sinara-hw/Pounder/README.md

# Pounder
PDH/phase lock signal generator for Stabilizer

## Design Files

Design files (schematics, PCB layouts, BOMs) can be found at [Pounder/Releases](https://github.com/sinara-hw/Pounder/releases).

## Wiki

More information can be found on the [wiki](https://github.com/sinara-hw/Pounder/wiki).
