sinara-hw/Pounder/(threads)

Thread 1 (2018-11-12):

[RFC] New EEM: Pounder (PDH lock signal generator)

dtcallcock, 2018-11-12:
[Pound Drever Hall](https://en.wikipedia.org/wiki/Pound–Drever–Hall_technique) locks are pretty ubiquitous in laser labs.  It would be nice to have a Sinara board that does all the necessary modulation and demodulation.

It would sit alongside one of the proposed servo cards such as [Stabilizer (Microcontroller Servo)](https://github.com/sinara-hw/meta/issues/27) or [Fast Kasli Lock](
https://github.com/sinara-hw/meta/issues/26).

There are commercial models available from [Toptica](https://www.toptica.com/products/tunable-diode-lasers/laser-locking-electronics/pdd-110f-pound-drever-hall/), [Also Toptica](https://www.toptica.com/products/tunable-diode-lasers/laser-locking-electronics/pdhdlc-pro-pound-drever-hall/), [Sacher](https://www.sacher-laser.com/home/lab-equipment/locking_equipment/servo_controller/top_of_line_modulator_demodulator-lb20.html), [Qubig](http://www.qubig.com/rf-drivers.htm), and [Stable Laser Systems](http://stablelasers.com/products/pound-drever-hall-signal-unit/).  I haven't used most of them but none look like they quite do what we want.  At NIST we usually just roll our own from a two-channel standalone DDS, a pile of Minicircuits bits and some custom passive rf filters and a custom active LPF on the output.

Interface could be EEM and/or Ethernet.  Having no Ethernet will be obnoxious if we don't want to put an EEM master on Stabilizer.  Having ethernet could also make the board on option for people who aren't otherwise using Sinara - the fact there are quite a few commercial products out there demonstrates there is at least some market.

dtcallcock, 2019-06-02:
Just to finish answering @gkasprow questions:

> Low pass filter series: LFCN-3000+

Yes, the Minicircuits FV1206 package used in this part should be fine for DDS band defining filters.  How about [LFCN-160+](https://www.minicircuits.com/pdfs/LFCN-160+.pdf) (-1.5dB @205MHz, -19dB@300MHz) as the default population?

> Fixed attenuators: YAT-12+

MCL YAT series sounds fine.

> modulators: ADL5375-05ACPZ-R7, ADL5380ACPZ-R7

I think we just want a double-balanced mixer rather that an AD part. Will open another thread on this.

> Low noise generators: CCHD-950-25-100.000, Si570, Si549

See thread on DDS clocking.

dtcallcock, 2019-06-02:
> what are the second two dds channels for?

For the other PDH channel that's a copy of the first.  Reasoning from above:

- It isn't much extra work (just copy and paste the analog section) and will probably add <100 of $ to the board cost.
- Stabilizer is 2-channel
- A lot of atomic references also have an AOM in the pump beam to offset it. You could use one of the two LO outputs for this instead of a second PDH lock. My guess it that this is why Qubig's box has an 'aux LO' output.

gkasprow, 2019-09-21:
Here are more-or-less finished schematics. CPU IO assignment is missing.
[Pounder.PDF](https://github.com/sinara-hw/Pounder/files/3639019/Pounder.PDF)

Closed 2019-11-30.

Thread 2 (2019-06-02):

DDS Clocking

dtcallcock, 2019-06-02:
How about using the same 100MHz oscillator ([CCHD-950-25-100.00](http://www.crystek.com/crystal/spec-sheets/clock/CCHD-950.pdf)) and MUX ([Si53340-B](https://www.silabs.com/documents/public/data-sheets/si5334x-datasheet.pdf)) as Urukul to allow selection between XTAL and ext ref?

Only issue is that Si53340-B has LVDS outputs and AD9959 datasheet only talks about connecting LVPECL and PECL clocks.

Ext ref could be a front panel SMA or internal MMCX depending on front panel space and perceived likelihood people will use it.

To answer @hartytp questions:

> what’s the use-case for the ext ref? Synchronised locks?

Yes.  But also:
- In some kinds of modulation schemes (like ones with an offset AO) the DDS output gets added to the laser frequency and so you might want that frequency locked to a reference.
- The phase noise of the DDS is improved by bypassing the internal multiplier.  An ext ref would allow people to provide their own low phase noise 500MHz reference.

> If so is it worth having a ref out port?

Sure.  One of the other outputs of the MUX could be taken to an MMCX.

gkasprow, 2019-06-02:
The AD9959 clock input requires min 400mVpp input clock.
The Si53340-B specification says that it delivers 200mV..490mV single ended swing which means min 400mV pp. So that should work. If we route 120Ohm tracks and place 120Ohm load than we would get sth like additional 20% margin. But IMHO we already are well within spec.

dnadlinger, 2019-07-17:
> what’s the use-case for the ext ref? Synchronised locks?

For fibre noise cancellation (#7), one would definitely want to use a good external reference as well.

gkasprow, 2019-09-21:
copied directly from Urukul, added SMA input isolation
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

dtcallcock, 2019-09-21:
Can Q1 go to an MMCX so that the 100MHz internal oscillator is available if needed?

> added SMA input isolation

So EXT_CLK IN is a front panel SMA?  if so, what are the CK MMCX annotations next to CLK1 input on IC24?

gkasprow, 2019-09-21:
It is reminiscent from Urukul. Yes, it is SMA. OK for internal MMCX

dtcallcock, 2019-10-08:
Closing as new issues opened for remaining issues.

Closed 2019-10-08.

Thread 3 (2019-06-02):

Power Amp

dtcallcock, 2019-06-02:
An output amp that can do more that +10dBm would be useful as often with a PDH you are often driving a modulator like an EO.  I see three options:

- Add [TSS-13HLN+](https://www.minicircuits.com/pdfs/TSS-13HLN+.pdf) that can be switched in and out of output as described in [main thread](https://github.com/sinara-hw/Pounder/issues/1).  The [HMC1118](https://www.analog.com/media/en/technical-documentation/data-sheets/HMC1118.pdf) switch looks like it will be able to handle the power.  Power dissipation is 2W/channel and it might add ~$50 to the BoM.

- Leave room for power amps but make them DNP by default.  In that case I'd probably use the [PHA-13LN+](https://www.minicircuits.com/pdfs/PHA-13LN+.pdf).  It's a little less power (+23dBm) but it's an easily hand-solderable package and runs off 5V so wouldn't need dedicated rails populating (current draw is 160mA max per amp so presumably not that bad to build that margin in the existing 5V rail).  Lack of enable line also not an issue here.

- We could make a separate medium power RF amplifier board in Eurocard form factor (prob 2 ch).  Such a thing would be useful for other boards like Urukul/Mirny too - right now there is a bit of a gap in Sinara if you need RF power in the +10 to +25dBm range where Booster would be total overkill.

hartytp, 2019-06-02:
For AOs you’d usually need a bit more power than those wouldn’t you? The nice qubig EOs only need something like 13dBm. So is there enough of a use case for >16dBm <28dBm (which is prob more than you’d get after the switch) to be worth the hassle?

Personally I’d go for the biggest MMIC amp we’d be happy with (16dBm ish ideally) and let users stick an appropriate pre-packaged mcl amp on outside stabiliser if they need it (can always provide a header).

dtcallcock, 2019-06-04:
> For AOs you’d usually need a bit more power than those wouldn’t you?

Yes, but then using Booster would be reasonable.

> The nice qubig EOs only need something like 13dBm.

It's true that for some cavity locks powers can be really low.  For atomic locks though we run them with as much as 23dBm.

> stick an appropriate pre-packaged mcl amp on outside stabiliser if they need it (can always provide a header).

Isn't this the kind of thing we are trying to move away from with Sinara?  Is option 2 above much harder than this - it's just a MMIC so only needs a handful of external passives around it.

hartytp, 2019-06-04:
>  Is option 2 above much harder than this - it's just a MMIC so only needs a handful of external passives around it.

It's not so hard. The chip eats 140mA at 5V (700mW) so you'll have to make sure you spec the circuit out for this. Will prob require a 5V5 SMPS on the AFE mezzanine to generate the supply for that from the main 12V rail. That may be necessary anyway, depending on how much current the other components draw from that rail.

If it's a bit of a niche use-case then solder jumpers sound like a good idea (maybe populate the amp by default but use a 0R resistor to cut off its supply to make life easier?). If it's going to be common then worth thinking about the switches more seriously

dtcallcock, 2019-06-04:
> If it's a bit of a niche use-case then solder jumpers sound like a good idea. If it's going to be common then worth thinking about the switches more seriously

Yeah, I think that given the switch has to be a bit extra-special then solder jumpers are the way forward.

> maybe populate the amp by default but use a 0R resistor to cut off its supply to make life easier?

That would be my preference.  Adds $20 to the BoM is all.

hartytp, 2019-06-04:
Sounds good. If we find people aren't using it, we can always DNP it later on.

FWIW, I'd also be fine with connecting it to the output by default (I'm not so concerned with an extra 0.7W of power dissipation for this design as we won't have many channels of it).

gkasprow, 2019-09-21:
Attenuator schematic
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
power stage and switches
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

gkasprow, 2019-09-21:
What about using HC164 to drive the VGA?

gkasprow, 2019-09-21:
Or, I2C extenders would be simpler...

gkasprow, 2019-09-21:
Would it be OK from SW perspective to chain both attenuators serial interfaces and drive them from the same SPI?

dtcallcock, 2019-09-22:
If we go for the PHA-13LN+ amp (P1dB=+24dBm), which I think is probably the right choice, then we don't need those fancy HMC1118 switches (~$7 ea).  We can just re-use the [HMC349ALP4CE](https://www.analog.com/media/en/technical-documentation/data-sheets/HMC349ALP4CE.pdf) from Urukul. That switch is half the price and known-good.  The 0.1dB compression point is +31dBm and power handling is +33.5(+26.5) dBm on thru(terminated) path so it can handle the power.

The way the switches are connected right now, there isn't a way of switching off the output.  Obviously you could switch to the power amp route but leave the power amp powered down.  I don't know if that's safe or how much isolation it would give though.  On the other hand, the DDS has amplitude control so one can just set that to zero if desired.

dtcallcock, 2019-09-22:
The passives around the [PHA-13LN+](https://www.minicircuits.com/pdfs/PHA-13LN+.pdf) don't match the suggested datasheet values.  Also there is capacitor missing (C1 on datasheet) and the input capacitor and inductor (C2 and L2 on datasheet are switched).  Is there a reason for this?

dtcallcock, 2019-10-08:
> We could make a separate medium power RF amplifier board in Eurocard form factor (prob 2 ch). Such a thing would be useful for other boards like Urukul/Mirny too - right now there is a bit of a gap in Sinara if you need RF power in the +10 to +25dBm range where Booster would be total overkill.

It sounds like this might be worth revisiting if there isn't a suitable MCL amp.

Otherwise closing.

Closed 2019-10-08.

Thread 4 (2019-06-02):

Mixer

dtcallcock, 2019-06-02:
>>>> We use Minicircuits [SYPD-1+](https://www.minicircuits.com/pdfs/SYPD-1+.pdf) phase detectors btw. Does anyone have experience with something else?

>>> IIRC, there is nothing special about those phase detectors, they're just mixers. Any decent (good isolation/LO leakage) will do just fine.

>> Yep. The main reason we use them is that they are specified for phase detection so you know what performance you will get rather than having to infer or test - for example with a random mixer you may end up with some annoying drifty dc offset. Minicircuits have a nice application note on the subject.

> IIRC, the phase detectors are mainly specified with the RF input saturated, which is not what one generally wants for an atomic lock. With the RF input unsaturated there is less difference between a phase detector and a decent DBM. There is a good Marki app note on mixers as well. IIRC their conclusion is that isolation is a very good proxy for general mixer performance and, having done some really careful tests that use mixers as phase detectors, I've never had an issue with large offsets in mixers that have decent isolation/LO leakage etc.

> Anyway, if there is a phase detector mixer that covers the frequency band, power range etc that we need then sure, let's go for it. If not, then let's just use a decent mixer. I'm equally happy either way.

@hartytp Do you want to suggest a part number you have had good experience with or shall we go with the SYPD-1+?

hartytp, 2019-06-02:
I’ve done quite a lot of microwave interferometry recently and have generally found that any MCL DBM will be fine. The Marki app note is prob right that isolation is a good thing but usually the mcl/marki/etc mixers all have about the same specs. I can dig out the pn of the mixer we used in our home brew pdh box if you want, but personally I’d just go for anything with the right frequency range

dtcallcock, 2019-06-03:
> I can dig out the pn of the mixer we used in our home brew pdh box if you want, but personally I’d just go for anything with the right frequency range

You used an MCL [ADE-1L](https://www.minicircuits.com/pdfs/ADE-1L.pdf) but it doesn't quite go low enough in frequency.  It looks like the MCL [ADE-1+](https://www.minicircuits.com/pdfs/ADE-1+.pdf) will do the job though.

Btw, here is another nice article on mixer selection: http://www.rfcafe.com/references/articles/wj-tech-notes/Mixers_phase_detectors.pdf

dnadlinger, 2019-07-17:
Measurements of DBM residual phase noise are hard to come by. There is a NIST paper with some results: Barnes et al., Residual PM Noise Evaluation of Radio Frequency Mixers (2011), [doi:10.1109/FCS.2011.5977868](https://ieeexplore.ieee.org/document/5977868). As Tom mentioned, most should work for our use case.

dnadlinger, 2019-07-18:
> the phase detectors are mainly specified with the RF input saturated

Just for the sake of completeness, for fibre nosie cancellation (#7), we'd want to use the mixer as a pure phase detector, i.e. well saturated.

gkasprow, 2019-09-20:
What's the conclusion then?
 Is MCL ADE-1+ fine?

dnadlinger, 2019-09-20:
The ADE-1+ looks like it should work. Let's just make sure that we have enough LO power available to saturate it (probably around 10 or 11 dBm), and to terminate the IF output into 50Ω at high frequencies (series RC to ground plus LRC for the DC path).

gkasprow, 2019-09-20:
OK, what about the LO amplifier? Would [ERA-2SM+](https://ww2.minicircuits.com/pdfs/ERA-2SM+.pdf) work here?
We also need VGA. What gain and frequency range do you need? Do you have some candidate?
Digitally controlled would be fine, but we have also two free DAC outputs from CPU.

gkasprow, 2019-09-20:
What about the coupler? Would [TCD-9-1WX+](https://ww2.minicircuits.com/pdfs/TCD-9-1WX+.pdf) already used in the Booster work for you?

dtcallcock, 2019-09-20:
> OK, what about the LO amplifier? Would ERA-2SM+ work here?

Looks good.

> What about the coupler? Would TCD-9-1WX+ already used in the Booster work for you?

No, that part is 5-2000 MHz.  I want to run the LO as low at 1MHz.

> We also need VGA. What gain and frequency range do you need? Do you have some candidate?
Digitally controlled would be fine, but we have also two free DAC outputs from CPU.

Where on the [block diagram](https://github.com/sinara-hw/Pounder/issues/1#issuecomment-497855600) would this VGA be?

dnadlinger, 2019-09-20:
> What about the coupler? Would TCD-9-1WX+ already used in the Booster work for you?

Not for the low-frequency locks @dtcallcock is targeting. The frequency range (1 MHz to 160 MHz) is a bit awkward in terms of directional couplers, though. Perhaps we can just use a tap as we don't need directionality? [ADCB-20-82+](https://ww2.minicircuits.com/pdfs/ADCB-20-82+.pdf) looks like it might be an option otherwise; I haven't had a look at other manufacturers parts.

gkasprow, 2019-09-21:
cannot we just use resistive power divider?

gkasprow, 2019-09-21:
There is a VGA driving the coupler

gkasprow, 2019-09-21:
I will use [LT5554](https://www.analog.com/media/en/technical-documentation/data-sheets/5554f.pdf)

gkasprow, 2019-09-21:
What cutoff crequency do we need at the mixer output?

gkasprow, 2019-09-21:
initial schematic
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

gkasprow, 2019-09-21:
I will add opamp lowpass filter at the output once i know the cutoff frequency

gkasprow, 2019-09-21:
power detector
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

dnadlinger, 2019-09-21:
To keep things organized, let's close this issues as we've decided on a mixer (for now, anyway).

@gkasparow: I assume ADPQ-2-250 is just a stand-in? Frequency range of course wouldn't work for us. For the DDS reconstruction filters posted elsewhere, 200 MHz like on the eval board would seem more appropriate, given that we are planning on using it at 160 MHz.

gkasprow, 2019-09-21:
Yes, I didn't change it while modifying other components. Of course, we will use ADCB-20-82+.
FL3 is LFCN-160.

dnadlinger, 2019-09-21:
For the splitter, a resistive tap might work just as well, I'll leave that for someone else to comment on.

Closed 2019-09-21.

Thread 5 (2019-06-02):

Output filter

dtcallcock, 2019-06-02:
Filter to go between mixer output and Stabilizer.

In order to take advantage of a potential future FPGA-based fast Stabilizer we should have the option to make this pretty minimal:

> the bandwidth of the signal chain after downconversion should be roughly 10 MHz to not completely take up the phase margin of a 2–3-ish MHz feedback loop

>One usually has a band-stop filter (LPF costs too much phase margin) after the mixer to remove any LO leakage, which can otherwise get rectified by following stages, degrading the DC stability. Since we would like to support a wide range of LO frequencies, this will either need to be a fixed filter selected by users (probably the easiest option) or widely tunable. A SDR approach might be fun here. ie. a minimal fast AFE after the mixer and then rely on a fast ADC + DSP to do the filtering as well as the loop-filter

However for things like slow atomic locks a fairly aggressive LPF would be nice.

Also need to decide how much gain is needed.

hartytp, 2019-06-02:
Probably best to do as much of the lpf in software as possible, does this lpf need to do any mare than remove rf leakage? Stabiliser actually already has this so nothing needed there, but maybe keep pads for something in case?

dtcallcock, 2019-06-03:
> does this lpf need to do any mare than remove rf leakage? Stabiliser actually already has this so nothing needed there

I don't think that's true - stabiliser has 1MHz of bandwidth but we want to be able to run the rf as low as that.  I also think it might be worth helping the digital filter out a bit by not making it average through 1MHz of noise bandwidth (and something like an Iodine lock is very noisy) for a 100Hz bandwidth lock.

I think my preference would be to buffer the mixer with an op-amp circuit as shown on page 2 of the [MCL app note](https://www.minicircuits.com/app/AN41-001.pdf).  This circuit would have the full 10MHz of bandwidth but have component pads to allow this to be reduced to as low as say 10kHz.

dnadlinger, 2019-07-17:
Just to state the implicit assumptions: The mixer output filter should be a decent 50Ω termination at higher frequencies and provide some kΩ of load at DC (e.g. an AC-coupled 50Ω termination plus an LCR lowpass as in Figure 2 of the above paper).

I'd also use an op-amp with reasonable EMI rejection, just in case. A low-noise FET-input opamp should definitely work. The choice somewhat depends on the target bandwidth; e.g. OPA828 or ADA4625.

For use as a phase detector, we should only need a gain of a few.

dnadlinger, 2019-07-29:
The "above paper" should have been the one mentioned in #4: Barnes et al., Residual PM Noise Evaluation of Radio Frequency Mixers (2011), doi:10.1109/FCS.2011.5977868.

gkasprow, 2019-09-21:
Filter schematic
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

Filter response including component tollerances
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

hartytp, 2019-09-23:
@gkasprow For the output OpAmp supply, can we go for +-5V instead of +-12V?

My logic here is that we never need more than +-1V output for S/N reasons and I'd like this design to work well for fast applications (diode laser line width narrowing) where the total loop BW is a couple of MHz, so the filter should provide 10MHz of bandwidth to avoid degrading the phase margin too much.

+-1V is generally nicer for fast ADC front ends, and there are many more choices for fast OpAmps with 10V supply than 24V supply.

Aslo, can you set the AFE gain so that the output is approx +-1V (2Vpk-pk) when the mixer is saturated, and add an annotation about this please?

hartytp, 2019-09-23:
I'd also prefer to use a faster OpAmp to make it easy to increase the BW by changing passives if desired.

dtcallcock, 2019-10-08:
Closing as new, more specific, issues cover all the points above.

Closed 2019-10-08.

Thread 6 (2019-06-03):

form-factor

hartytp, 2019-06-03:
Double checking: is everyone happy making this a stabilizer AFE mezzanine instead of a stand-alone eurocard? (Probably copy most of it directly from Stabilizer, including PoE and EEM connector).

Might be worth making a decision about how we want to do the fast servo first (https://github.com/sinara-hw/meta/issues/26?_pjax=%23js-repo-pjax-container#issuecomment-498192023). IME if the fast servo is going to be an EEM then this should probably be a standalone card. If the fast servo is going to be a stand-alone card (fast stabilizer) then we should make this an AFE.

dtcallcock, 2019-09-07:
If someone needs to use Pounder standalone then isn't that still possible if it's a Stabilizer AFE?  The Pounder outputs are automatically available on the stabilizer SMA 'input' connectors.

The main disadvantage I see is that 'standalone Pounder' becomes 8HP instead of 4HP and would be slightly more expensive.  That seems like a worthwhile tradeoff for the board simplification and cost reduction though.

> Might be worth making a decision about how we want to do the fast servo first (sinara-hw/meta#26).

If the fast servo does digital PDH then this will be a moot point.

dtcallcock, 2019-09-22:
Re-open if you have second thoughts about current Stabilizer AFE plan.

Closed 2019-09-22.

Thread 7 (2019-07-17):

Fibre noise cancellation using Pounder

dnadlinger, 2019-07-17:
Apart from various laser frequency locks, a common use case right up Pounder's alley would be fibre noise cancellation. There are few implications for the design beyond what we already have; I'll create separate issues/comments for them. This is the general overview/tracker issue on the topic.

For the uninitiated, the basic problem is that thermal and acoustic noise in optical fibres leads to drifts in the total path length that are significant below some kHz laser line width. By reflecting a portion of the transmitted light back through the fibre, (twice) the accumulated phase difference can be measured at the source end and hence compensated by applying an an appropriate phase shift before the fibre.

This is usually done by inserting an acousto-optical modulator before the fibre, driven at some frequency f_AOM, e.g. 80 MHz. The retro-reflected light passes the AOM again and is interfered with the unshifted light to create a beat note, which is mixed down using a high-quality LO at 2 * f_AOM and stabilised. The loop bandwidth is usually some tens of kHz, limited by the fibre (and AOM) propagation delays.

In the early literature ([1](https://www.osapublishing.org/ol/abstract.cfm?uri=ol-19-21-1777), [2](https://www.spiedigitallibrary.org/conference-proceedings-of-spie/2378/0000/Accurate-cancellation-to-milliHertz-levels-of-optical-phase-noise-due/10.1117/12.208231.s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)) as well as in the Zürich TIQI group ([3](https://tiqi.ethz.ch/content/dam/ethz/special-interest/phys/quantum-electronics/tiqi-dam/documents/semester_theses/semesterthesis-nelson_darkwah_oppong.pdf)), this was typically done by driving the AOM using a VCO. (From what I know, similar systems exist at JILA/Innsbruck/… as well.) I don't see a reason why this couldn't be done much more conveniently using a DDS, though.

On Pounder, we would use one DDS to create a stable LO at 2 * f_AOM (e.g. 160 MHz). For this, we definitely want to be able to clock the DDS of a good external reference (and pay some attention to PLL quality), as this sets (a limit to) the stability of the optical frequency. The second DDS would run at half that frequency, f_AOM (e.g. 80 MHz), with frequency and phase offset constantly being updated by Stabilizer to implement a PI loop response.

Additionally, in many lab-local use cases it would be convenient to use the same AOM to also stabilise the optical power after the fibre (and polarisation cleanup) by feeding back onto the RF drive amplitude. For this, one would connect a photodiode to the second Stabilizer ADC channel, feeding back onto the DDS amplitude word.

The obvious choice would be to use two AD9910s and an FPGA, with the parallel interface wired up for one of them. Since we don't need a lot of loop bandwidth here, though, it looks like a single AD9959 should work too. Its SPI interface appears to be faster than that of the AD9910, up to 200 MHz, and 10 bit should (barely) be enough. A single update would be 72 bits, so using 100 MHz SPI (SDR) driven from the Stabilizer ARM core should get us > 1 MHz update rate. (There will be processing latency, … on top of that, of course.) There would be an advantage to using a pair of AD9910s, though, namely the higher frequency range – many commonly used AOMs in the blue are run at 200 MHz, so having 400 MHz in the first Nyquist zone would be somewhat convenient..

As discussed in #4, most decent mixers should be good enough not to be a limitation in terms of system phase noise performance. We definitely want to be able to saturate it well using the LO, though, that is, to use it as an AM-insensitive phase detector. (One could use a PFD just as well, but capture range isn't relevant here, as the average frequency will always be exactly half the known LO frequency.)

Features discussed elsewhere which are not relevant for this:
 - Output amplifier (there is going to be an AOM power amp anyway)
 - Second channel (the second ADC is taken up by intensity stabilisation)

dtcallcock, 2019-08-30:
> it looks like a single AD9955 should work to

Do you mean the AD9959 (I'm guessing this is a typo as AD9955 is long obsolete)?

>  There would be an advantage to using a pair of AD9910s, though, namely the higher frequency range – many commonly used AOMs in the blue are run at 200 MHz, so having 400 MHz in the first Nyquist zone would be somewhat convenient.

Do you think it's worth opening an issue to discuss DDS choice or are you happy to stick with AD9959?

gkasprow, 2019-09-20:
What about adding EEM connector to the Pounder? One can then connect it to Kasli and drive with 200MHz SPI.

dnadlinger, 2019-09-20:
> Do you think it's worth opening an issue to discuss DDS choice or are you happy to stick with AD9959?

I'm happy to stick with the AD9959 if we are going for a two (well, four) channel design. The extra BOM cost for 4xAD9910 over a single AD9959 seems a bit hefty for spectroscopy-type applications. For most noise-cancelled fibre links (674 nm/729 nm/…) 80 MHz AOMs are perfectly good anyway, and for other applications, we can spin a second board with 2xAD9910 down the line, cook something up using Kasli, or play around with harmonic downconversion.

gkasprow, 2019-09-20:
One can also connect external Urukul to Sampler when the higher frequency is needed - Sampler has downstream EEM port.

dtcallcock, 2019-09-20:
> What about adding EEM connector to the Pounder?

This is a little non-trivial if we design the board with no front panel output, we are use >8 of the 16 DIO on the Stabilizer header and we use the Stabilizer CPU DAC and ADC.  All of these could be worked around if someone really thinks this is a good idea though.

gkasprow, 2019-09-21:
The DDS can work in SDIO x4 mode. At the moment, QSPI is routed to FLASH memory that is DNP right now. I can route it to the AFE header instead of general IO line. In this way we would use SPI1 for attenuator and QSPI for DDS.

dnadlinger, 2019-09-24:
I haven't checked the interfaces on either CPU or DDS end – maybe @jordens has an informed gut reaction here?

dtcallcock, 2019-10-08:
Closing as QSPI idea covered here: https://github.com/sinara-hw/Pounder/issues/10

@dnadlinger reopen if you want to discuss this use case further in light of other issues.

Closed 2019-10-08.

Thread 8 (2019-07-17):

Extra footprint for external IF

dnadlinger, 2019-07-17:
A population option to inject a custom IF signal e.g. by soldering on an extra SMA/MCX/… connector and switching over a 0Ω resistor would be useful for some more infrequent applications.

One application where this would be useful is using AOMs to phase-lock two beams after a pair of fibres (at some GHz offset, i.e. using an external mixer).

The optional connector could also be used as a convenient way of measuring the raw mixer output during debugging (with a third jumper position).

dnadlinger, 2019-07-17:
Hmm, thinking about this some more, it might be better to just run the external mixer directly into Stabilizer to avoid grounding funnies (with RF match/passive low pass in front, and using the Stabilizer input resistance for DC transimpedance gain).

Closed 2019-09-22.

Thread 9 (2019-07-17):

DDS SPI: SI, digital -> analog crosstalk

dnadlinger, 2019-07-17:
For PDH-type locks, the digital lines to the DDS(es) will mostly be quiet, but for fibre noise cancellation (#7), there will be continuous updates. We should be somewhat careful during layout to keep contamination to a minimum, particularly as one might end up with bus frequencies close to the RF/LO.

dnadlinger, 2019-07-17:
(The signal integrity on those lines of course must also be good enough to support high-speed operation of the serial bus.)

dtcallcock, 2019-09-07:
If Pounder is a Stabilizer AFE then this signal integrity requirement also applies to Stabilizer.

@gkasprow Do you think the GPIO header on Stabilizer is up to running a 100-200MHz SPI interface?

gkasprow, 2019-09-07:
The GPIO header should not be an issue, I'm not sure about the CPU. I can make the SPI properly terminated 50Ohm (or 75 ohms) and increase the track clearance to support such a mode.

gkasprow, 2019-09-21:
DDS schematic
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

jordens, 2019-10-12:
dds schematic looks good.

jordens, 2019-11-27:
Also ensure SPI CLK digital cleanliness, maybe even using the same approaches as on Fastino.

gkasprow, 2019-11-30:
I terminated all fast digital SDIO lines

Closed 2019-11-30.

Thread 10 (2019-09-21):

DDS control

gkasprow, 2019-09-21:
What shall I do with P3...P0, SYNC_IN, IO_Update pins? Shall I route them to ordinary IOs or there are some special wishes?
And what about using QSPI in STM32. It is optimized for FLASH, but one can disable addressing and transfer ordinary data as well.

gkasprow, 2019-09-29:
@jordens did you use STM32 QSPI FLASH interface in SDIO mode? AD9959 has such access mode.

jordens, 2019-09-30:
I haven't used the quadspi peripheral. Might work with that dds.

gkasprow, 2019-09-30:
Let's add 0R resistor option so we can switch to SPI in case of issues.

jordens, 2019-10-12:
The quadspi Periphareral is ok for this. Memory mapped access will be of very limited use because of the variable register length. For phase locking (fiber length stabilization is a pll) doing it on both channels would be tricky because of the way the target channel is switched. But that's a limitation of the dds, not the spi bus.

jordens, 2019-10-12:
* SYNC_IN should be a CPU timer channel output and SYNC_OUT should also go to a timer input. Or ignore both if you are short on pins.
* IO_UPDATE and P0-3 should go to GPIOs, preferrable within the same GPIO bank of the CPU.

gkasprow, 2019-11-30:
control signals assignment
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

Closed 2019-11-30.

Thread 11 (2019-09-22):

Schematic rc

hartytp, 2019-09-22:
@gkasprow can we have a pdf of the current schematic release?

gkasprow, 2019-09-29:
It's here
[Pounder.PDF](https://github.com/sinara-hw/Pounder/files/3666655/Pounder.PDF)

hartytp, 2019-09-29:
Thanks @gkasprow !

I'll review this tonight.

To be clear though, I will only do a very high-level review. From experience, I've found it's essential that someone (other than Greg, since fresh eyes are necessary) does a detailed review, which I won't be able to do for this design. @dtcallcock will you do this? It's something that really shouldn't be a "learning project" for a student, since it needs someone whose made some mistakes before. Even if much of the design is copy-paste, it's still easy for bugs to creep in when bits are moved from one design to the other

FWIW, the things I typically look at include for every IC on the board:
- [ ] Abs max rating for all pins
- [ ] Pin descriptions
- [ ] reference designs/eval boards
- [ ] Necessary capacitances v(e.g. LDO stability), compensation components, etc
- [ ] Thermal management/power budgets and handling
- [ ] max currents
- [ ] skim of basic specs to look for potential isues
- [ ] voltage standards, etc
- [ ] quality of annotations
- [ ] check someone is looking carefully at the digital stuff (@jordens ?)

That's about it, on top of general sanity checking.

Anyway, sorry if that's stating the obvious, but I want to make sure it doesn't get overlooked, since my experience is definitely that skimping on design reviews wastes huge amounts of time

dtcallcock, 2019-09-29:
> @dtcallcock will you do this?

Yes, though I'm a bit swamped this week with the start of term and family visiting.

> check someone is looking carefully at the digital stuff (@jordens ?)

I'm looking into funding firmware development that will include making sure the right connections are there.

hartytp, 2019-09-29:
High-level review complete. Looks like a cool design once the details are sorted.

Looking forward to removing some more crappy electronics from my lab once this project works ;)

dtcallcock, 2019-10-08:
I've done a first-pass.  Probably makes sense to have a new version and a preliminary power budget before looking again @gkasprow?

gkasprow, 2019-11-30:
I will open new issue once rc is ready

Closed 2019-11-30.

Thread 13 (2019-09-23):

vga

hartytp, 2019-09-23:
Is 18dB max enough gain for the VGA? Would it be easier to just add the same digital attenuator on Urukul etc followed by a fixed-gain pre-amp?

dnadlinger, 2019-09-24:
Wouldn't the VGA typically be used only to fine-tune the gain after you've used an external amplifier (e.g. an amplified photodiode) to get you close enough? Sure, having to fiddle with external attenuators/multiple cascaded amps/etc. is annoying, but it seems like an 16 dB window is wide enough to easily hit when designing/choosing the detection chain.

Without having calculated actual numbers, it seems like 18 dB gain ought to give you decent performance at -20 dBm input power or something like that.

jordens, 2019-11-27:
I would also think that a step attenuator (that's already present on the BOM) plus a fixed amplifier (that's also present on the BOM) is better than the PGA. Wider range, no more useful step sizes. Maybe also less insertion loss and thus better overall noise figure than the PGA. Also saves at least one transformer.

jordens, 2019-11-28:
* If you go for the step attenuators, hook them up in daisy chain with the two existing attenuators, but use individual LE lines (4 LE, 1 CLK, 1 SDI, 1 SDO).
* No need to wire ATT_RSTn on any of the attenuators IMO.
* OSC_en, DDS_RESET, EXT_CLK_SEL and the attenuator lines can all go onto a IO extender (I2C or SPI). No need for CPU GPIO.
* Update to the current Stabilizer IO connector pinout.

gkasprow, 2019-11-30:
@hartytp are you happy with two attenuators followed by ERA-2SM+ instead of PGA?

hartytp, 2019-11-30:
I’m happy either way

hartytp, 2019-11-30:
@dtcallcock should comment however

dtcallcock, 2019-12-01:
I don't see a problem with this way of doing it.

gkasprow, 2019-12-01:
@jordens I assume you don't plan to use hardware NSS pin because we will always transmit 48bits

jordens, 2019-12-01:
On the attenuators?

gkasprow, 2019-12-01:
yes

jordens, 2019-12-01:
Yes. We can always load all attenuators. Here it's fine since it's easy to track the state either in software or by doing the non destructive procedure we have for urukul initialisation.

jordens, 2019-12-01:
But why is it 6 attenuators?

gkasprow, 2019-12-01:
We have two in output state and two cascaded instead of VGA, But I don't understand why we need to cascade two of them.

hartytp, 2019-12-01:
I don't remember why we have two of them either. (I also can't remember why we decided to use the attenuator instead of the VGA)

jordens, 2019-12-02:
I don't get why we need the VGA. The VGA gives you 2-18 dB gain, while using the existing step attenuator+gain block would give you -8 to 22 dB gain. And it has a 6 dB better noise figure!

gkasprow, 2019-12-02:
To cover required -20..+10dBm range we would need to cascade two amplifiers to have 10dBm on the mixer input. I'm not sure we need that much because we can also increase the gain with opamp at the mixer output and work with let's say 0dBm.

jordens, 2019-12-02:
Yes. Absolutely. The power at the mixer input only needs to be raised sufficiently to not matter for the noise. Going very high into the mixer (10 dBm) even for low input powers (-30 dBm) also kills the overall dynamic range. If we accept 10 dBm max input then with a 31.5 dB attenuator, 3 dB overall insertion losses, and a 24 dB gain block, we are at 0 dBm into the mixer and can maintain that 0 dBm level all the way down to -21 dBm RF input. Below that we start loosing performance, but probably only because of the noise figure of the input. Nothing a good external preamplifier and filter wouldn't solve. Above 10 dBm we would start clipping in the opamps which may also be fine since we tend to work in quadrature, i.e. at 0 V mixer output. Later the gain block would saturate before everything goes up in flames.

hartytp, 2019-12-02:
> And it has a 6 dB better noise figure!

At low power levels. Obviously the NF is worse than -30dB at max power.

gkasprow, 2019-12-02:
to use a single-stage gain block after the attenuator, we can go for one of them
[TSS-13HLN+](https://www.minicircuits.com/WebStore/dashboard.html?model=TSS-13HLN%2B) It  has NF=1.4 but costs 10.7$
Popular old [MAR-8A+](https://www.minicircuits.com/WebStore/dashboard.html?model=MAR-8A%2B) is just 1.5$ but has NF=3.1

jordens, 2019-12-02:
No point in trying to beat the transformer+attenuator insertion loss with an expensive amplifer afterwards. ERA-3 or MAR-8 is all fine. MAR-8 might be preferable because it moves the input range down.

jordens, 2019-12-02:
> At low power levels. Obviously the NF is worse than -30dB at max power.

More like 20 dB if you allow more power at the mixer.
But does that matter?

hartytp, 2019-12-02:
> But does that matter?

Likely not in most cases.

gkasprow, 2019-12-02:
So, what's the conclusion? Does such a solution work for all?
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

gkasprow, 2019-12-02:
edit, power levels were wrong

gkasprow, 2019-12-02:
If the gain of MAR8 is too high, it can be easily replaced with ERA2. It has the same footprint and bias current. Gain gets reduced from 31 dB to 16dB

hartytp, 2019-12-02:
@gkasprow does altium give one a nice way of swapping MAR8 FOR ERA2 in the BOM as a variant without having to have both on the schematic?

gkasprow, 2019-12-02:
Yes, but it must have the same footprint and come from the same library.
Old Altium could only add alternate value, the new AD can define component replacement.
variant1
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
Variant2
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

hartytp, 2019-12-02:
Aah, cool!

The reason I ask is that I'm thinking about making a high-frequency  (up to around 4GHz) version of Pounder with PLLs instead of DDSs. I assume this will be a new project that starts as a copy of Pounder, but was curious how much I might be able to do as a straight up variant...

gkasprow, 2019-12-02:
We still have some board area, but it would be probably easier to do as a separate project. Production would need to be done as a separate process anyway. Variant routing of 4GHz signal and shielding could be tricky.

gkasprow, 2019-12-02:
@hartytp do you want to make it like a dual-channel design?
If the rest remains the same, we can place synthesizer in the area under the shield in the rear board area
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
to support two channels, would you need two synthesizers?

hartytp, 2019-12-02:
I'm not overly fussed about one channel v 2. It probably makes sense to keep it as a new design since there will be a lot of changes (baluns, filters, mixer) and I'm not sure we'll be able to make everything FP compatible.

Closed 2019-12-01.

Thread 15 (2019-09-29):

output RF isolation

hartytp, 2019-09-29:
I'd really like to see the RF outputs properly isolated using 1:1 RF transformers and insulating washers around the SMAs.

This isn't just a theoretical concern. We often PDH lock our lasers by current modulating the laser and I've found that doing this without isolation transformers kills the laser performance. We lock quite a few of our IR lasers using Toptica PDH boxes, with current modulation, and in every case I've ended up having to add isolation transformers to suppress noise.

hartytp, 2019-09-29:
I'm less concerned about isolating the RF inputs and the clock input, since those tend to be less problematic (although, there's also no harm in doing it).

dtcallcock, 2019-10-08:
Sounds good.

Add DNP pads to allow user to connect to GND if desired though?

jordens, 2019-11-28:
And make sure that the two options are sensibly implemented. Always connect shield to the xfrm tap and then optionally that shield net to GND. Isolation xfrms on the inputs (clock and RF) are very nice.

gkasprow, 2019-11-30:
would[ ADT1-1WT+](https://www.minicircuits.com/pdfs/ADT1-1WT.pdf) do the job? We use them at the DDS outputs

Closed 2019-11-30.

Thread 16 (2019-09-29):

bi-dir coupler

hartytp, 2019-09-29:
Why are you using a bi-directional coupler instead of a 3-port directional coupler when you only need a forward power measurement? I've found the three port devices (with internal termination) tend to work better.

dnadlinger, 2019-09-29:
This is probably the one coupler Mini-Circuits has that goes all the way down to 1 MHz. Just building a simple tap from discretes might be the way to go, though.

gkasprow, 2019-11-30:
we can also go for [RDBC-20-63+](https://www.minicircuits.com/pdfs/RBDC-20-63+.pdf) which works from DC.
But can also be realized in the same way using just one resistor :)
The only coupler from Minicircuits that works from 1MHz is the one I used.

jordens, 2019-11-30:
You can't have both low frequencies and directionality. If you ensure a good match and isolation after/by the amplifier than then a tap is fine.

gkasprow, 2019-11-30:
well, you can build [directional coupler](http://michaelgellis.tripod.com/Bi-directional_amp.pdf) using opamps that work from DC :)
However, in our case we need to isolate LO leaking to RF input so existing solution may be optimal.

jordens, 2019-11-30:
Yeah. I thought I had restricted that statement to passive.

jordens, 2019-11-30:
The amplifier is pretty directional. You could put the tap between the step attenuator and the amplifier.

gkasprow, 2019-11-30:
True, providing that we go for this option instead of PGIA.

gkasprow, 2019-12-01:
I added 450R in series with power detector. This will give 10x attenuation

Closed 2019-12-01.

Thread 17 (2019-09-29):

filter supplies

hartytp, 2019-09-29:
let's power the mixer IF filter OpAmps from +-5V, since this gives far more OpAmp choices

gkasprow, 2019-11-30:
done

Closed 2019-11-30.

Thread 18 (2019-09-29):

document input power levels

hartytp, 2019-09-29:
It would be great to document (on the top page ideally) the RF input power level required to lightly (P1dB) saturate the input mixer with min/max PGA gain.

hartytp, 2019-09-29:
More a software point than a hw point, but it would also be great to have LEDs to indicate low/high power levels.

dtcallcock, 2019-10-08:
Also required input power level on ext_clk.

gkasprow, 2019-11-30:
There are 6  front panel green LEDs connected to the I2C expander

gkasprow, 2019-12-01:
Do we really need a double attenuator in front of ERA-2SM amplifier that drives the mixer?
with single attenuator, we accept -5.5dBm....+25.5dBm power level while driving the amplifier close to IP1.

hartytp, 2019-12-01:
I assumed we’d want the gain/attenuation setup to be more in the range -30dBm to 0dBm but @dtcallcock / @dnadlinger should comment on the desired range

gkasprow, 2019-12-01:
we would have to use an amplifier with much higher gain.
Single attenuator already has such gain window.

hartytp, 2019-12-01:
Indeed. I don’t think two attenuators is a good idea

We also need to be careful over attenuating too much in order to avoid noise issues with attenuate/gain cascades

hartytp, 2019-12-01:
I guess that’s the advantage of the vga... still, depends on what noise level people are looking to achieve here

dnadlinger, 2019-12-01:
-30dBm to 0dBm or -20dBm to 10dBm sounds more like it, yes.

gkasprow, 2019-12-01:
So, we definitely need to go for VGA. Otherwise we would need attenuator + dual stage amplifier

gkasprow, 2019-12-01:
The VGA gives only 2dB to 18dB Gain Range. Optimally we would need attenuator and then VGA, but this would add one RF transformer that isolates the input.
We can also place the attenuator after the VGA. The VGA should handle 10dBm of input signal (IIP3 is 27dBm).

hartytp, 2019-12-01:
If we need that much dynamic range vga followed by attenuator and fixed gain amp sounds good. 10dBm max input sounds fine

jordens, 2019-12-02:
I don't think we need that much dynamic range. A step attenuator gives us 31.5 dB dynamic range already. Apart from needing one more transformer, the VGA has a pretty disappointing noise figure and less dynamic range compared to step attenuator plus era-3. And we can't reuse the software architecture that we need for the other step attenuators.

hartytp, 2019-12-22:
Summarising this issue:
- [ ] @dtcallcock can you specify which max/min input power you want to support
- [ ] document this choice on the schematic
- [ ] design the attenuator/amplifier combo as well as the output buffer amp gain around this choice

dtcallcock, 2019-12-22:
I thought we were happy with the design @gkasprow laid out in #13

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

hartytp, 2019-12-29:
@dtcallcock okay, so you're happy with +12dBm being the max input, meaning drives the mixer at roughly its ~P1dB and gives approx +-1V at the Sampler input?

If so, @gkasprow are you happy that the amp isn't saturated, the mixer is driven appropriately and the filter gain is set correctly (and that this is all documented)?

If so, let's close.

dtcallcock, 2019-12-30:
Works for me.

On Dec 29, 2019, at 12:13, hartytp <notifications@github.com> wrote:

@dtcallcock<https://urldefense.com/v3/__https://github.com/dtcallcock__;!!C5qS4YX3!XJtI20KiljbKAAEYT-l2bDaEaK3zKUPPffZBWK361mLdkMJmt0uA5R4JtVwb7RQP-I0$> okay, so you're happy with +12dBm being the max input, meaning drives the mixer at roughly its ~P1dB and gives approx +-1V at the Sampler input?

If so, @gkasprow<https://urldefense.com/v3/__https://github.com/gkasprow__;!!C5qS4YX3!XJtI20KiljbKAAEYT-l2bDaEaK3zKUPPffZBWK361mLdkMJmt0uA5R4JtVwbU9gU52Q$> are you happy that the amp isn't saturated, the mixer is driven appropriately and the filter gain is set correctly (and that this is all documented)?

If so, let's close.

—
You are receiving this because you were mentioned.
Reply to this email directly, view it on GitHub<https://urldefense.com/v3/__https://github.com/sinara-hw/Pounder/issues/18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;Iw!!C5qS4YX3!XJtI20KiljbKAAEYT-l2bDaEaK3zKUPPffZBWK361mLdkMJmt0uA5R4JtVwbZTOtHuE$>, or unsubscribe<https://urldefense.com/v3/__https://github.com/notifications/unsubscribe-auth/AE5CIVRT4FKCFIRXVT33QL3Q3DLELANCNFSM4I3TSVWA__;!!C5qS4YX3!XJtI20KiljbKAAEYT-l2bDaEaK3zKUPPffZBWK361mLdkMJmt0uA5R4JtVwb_RT6NWk$>.

Closed 2019-12-30.

Thread 19 (2019-09-29):

filter amps

hartytp, 2019-09-29:
Can we use faster OpAmps for the filter please? I'd like this design to support ~10MHz analog bandwidth to make sure we can do fast locks on laser diodes (>=2MHz closed-loop bandwidth).

gkasprow, 2019-11-30:
Does this solution make you happy @hartytp
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

hartytp, 2019-12-22:
@dnadlinger what was your final thought about OpAmps and filters?

After giving it some thought, my preference would be:
- include DNPd pads for an LC LO notch filter (users populate based on their requirements)
- have a low-pass filter by default
- use a high-speed OpAmp as a buffer/amplifier with gain chosen to match the mixer output to Stabilizer's +-1V input range
- aim for closed-loop BW of the OpAmp buffer to be >10MHz to allow for few MHz loops without too much loss of phase margin due to the buffer
- don't bother with an active low-pass filter (in any case, Stabilizer has decent filtering which should do a decent job of carrier rejection)
- Use a low-noise/low-offset +-5V FET OpAmp for the buffer

Any objections?

hartytp, 2019-12-22:
Let's also aim to choose passives + OpAmp to minimize noise from the output stage

dtcallcock, 2019-12-22:
> Any objections?

Nope.

gkasprow, 2019-12-29:
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

hartytp, 2019-12-29:
Worth having a pad for a capacitor in parallel with L8A?

hartytp, 2019-12-29:
Looks about right, but it's worth simulating a couple of filters to make sure that we can get the appropriate component values in the packages you've chosen (ideally with tight tolerance LC components and without silly small/high values to avoid the need for tuning).

The thing I'd be most interested in would be a ~30MHz notch combined with a general low-pass response with a cut-off frequency around ~10MHz.

hartytp, 2019-12-29:
Hard to tell from the schematic you've drawn but is the idea to have the OpAmp with a G=2 to give +-1V output? If so it will have ~10MHz unity gain bandwidth, which is okay (a little more might be nice to minimize RF rectification given that the input filter needs a relatively high cut-off to allow closed-loop BWs of a few MHz).

hartytp, 2019-12-29:
Anyway, looks good to me other than that, so long as we can implement the filters that people want (@dtcallcock )

dnadlinger, 2019-12-29:
> a little more might be nice to minimize RF rectification

Assuming the JFET frontend is well-behaved, shouldn't there be pretty negligible RF rectification (especially with a notch to filter)? That is, doesn't the GBW limit only act to further suppress LO feedthrough (if there aren't any diode-like funnies going on in the input stage)?

hartytp, 2019-12-29:
I was wondering that too. I admit that I don't know the answer since I don't have a full model of the OpAmp in my head. As I understood it, even JFET OpAmps often start to get non-linear around the unity-gain point and so are prone to rectification.

Also, we're only notching at f_lo, not harmonics. I haven't looked at the mixer data sheet, so not sure how much power is in those (they may be taken out by a general low-pass filter, but depends on the various frequencies involved).

Anyway, I'm happy to concede that I haven't given this too much thought and the current design could be fine (so long as we can get the LCs we need in the packages Gerg's chosen).

gkasprow, 2019-12-29:
I used 0805 and 0603 footprints so there are many RLC options possible.

gkasprow, 2019-12-29:
JFETs have two diodes between inputs and go non-linear for signals which exceed opamp SR.

gkasprow, 2019-12-29:
To avoid rectification just add simple RC filter with let's say 20MHz BW.

hartytp, 2019-12-29:
@gkasprow okay. LGTM then.

FWIW I would consider a [THS4631[(http://www.ti.com/lit/ds/symlink/ths4631.pdf) as:
- quite a bit cheaper
- nice low noise JFE amp, low offset etc (although not quite as low as the AD8610)
- higher GBP which reduces potential issues with rectification.
- It does have a higher IQ, but nothing I'm particularly fussed about for this design, particularly given we have +-5V rails

Other than that:
- [ ] I'd add a DNPd cap in parallel with L8A
- [ ] Add a DNPd cap in parallel with R13A (for simple low-pass)

And call it quits unless anyone has any other comments/suggestions?

Can you post a design RC when you get the chance?

hartytp, 2019-12-29:
Well, the plus I can see for the AD8610 is the extremely low offset (absolute and temp co). Not clear to me which will give better performance in the field...

gkasprow, 2019-12-30:
I don't like THS4631. It has a strange input circuit that works only with low-level signals, i.e. in TIA applications. Once I used it as a CCD sensor buffer but it didn't work well with a 0.5V input signal. It has some kind of protection that increases leakage current orders of magnitude for higher voltages. I also tried it in switched analog integrator application but it did not behave as expected. Finally, for CCD I used matched JFET + bipolar opamp and for the integrator changed the conception because I could not find that fast JFET amp.

hartytp, 2019-12-30:
Okay. I guess it's the slew rate enhancement circuit you're talking about?

I've used that part in other designs without issue, but I'm happy to avoid it if you've had problems.

I don't like the AD8610 as it's expensive for what it is and a bit slow. If I have time I'll post some other suggestions but this shouldn't delay production IMHO.

Let's leave this for now and move onto the next RC.

gkasprow, 2019-12-30:
Let's use THS4631 here. I've just noticed how expensive AD8610 is. It works in standard amplifier application, nothing switching. In case of issues, we can change to AD8610.

hartytp, 2019-12-30:
That sounds good. There are some other nice LTC JFET amps that are also cheaper and faster than the 8610. They're not as fast as the THS part but have somewhat lower power consumption (but not quite by a factor of two). Ultimately it depends on what we want to optimize for. Anyway, this isn't a big decision as any of these parts should work.

BTW last time I used the THS was actually for the phase shifter in our in-house (analog) PDH system. It worked well for an RF OpAmp phase shifter designed by a grad student ;)

gkasprow, 2019-12-30:
Other FET OAs
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

hartytp, 2019-12-30:
OPA657 is also fine. I think I discounted it before because the input offset voltage is a bit worse, but we can live with it. I don't see any advantage over the THS however (it also has a worse slew rate). The 657 is just a decompensated 656. The 627 is a bit too slow really and has a pretty high quiescent current for that speed (typical of 7mA).

Out of those, I'd stick with the THS.

hartytp, 2019-12-30:
Well, actually, the 656 is generally nicer than the THS. But it takes up even more quiescent current. at ~12mA per amp it's starting to actually be quite a bit of power (e.g. the +5V supply is generated from +7.5V on pounder).

hartytp, 2019-12-30:
656 is also quite a bit more expensive.

hartytp, 2019-12-30:
@gkasprow AD8065?

hartytp, 2019-12-30:
Well, these designs always involve compromise and there is no right answer. So, I'm happy with any of those.

I'd probably go for the AD8065 on consideration, largely driven by the lower power consumption and low cost. NB it's not short-circuit protected so make sure to add a decent output protection resistor.

Anyway that's all I have to say on the subject. I'll leave it to @gkasprow to make the final call...

dnadlinger, 2019-12-30:
Typical EMIRR+ for precision JFET op-amps (e.g. [OPA828](http://www.ti.com/lit/ds/symlink/opa828.pdf), [AD4625-1](https://www.analog.com/media/en/technical-documentation/data-sheets/ADA4625-1.pdf)) at tens of MHz is 40 dB. As expected, this is quadratic in voltage for FETs and [referenced to 100 mV](http://www.ti.com/lit/an/sboa128a/sboa128a.pdf), so 100 mV RF feedthrough would give ~1 mV offset, which is substantial.

Really depends on the input filter design, of course.

hartytp, 2019-12-30:
100mV of input EMI sounds like a lot however. That won't come from mixer feed-through. If the external EMI is that bad, users should be able to use an external (coaxial) BPF to remove it.

tl;dr I don't think this will be an issue but an AD8065 or similar seems like a better choice than the OpAmp that's currently there. But, I don't want to get stuck talking about this, so happy to defer to anyone else who has a strong opinion.

gkasprow, 2019-12-30:
There is 9k1 resistor which makes LPF with opamp capacitance (3.9pF)

Closed 2019-12-30.

Thread 20 (2019-09-29):

IF gain

hartytp, 2019-09-29:
Let's make sure that saturating the mixer corresponds to +-1V output. That fits in nicely with the voltage range we're likely to have for the fast Stabilizer card -- +-10V is not necessary for S/N reasons and is a bit aggressive for high-bandwidth locks.

Let's also make sure that the output range is documented.

gkasprow, 2019-11-30:
@hartytp what levels can we expect at the output of such a diode mixer? Theoretically, it can be as high as the input signal, so it depends on the PGA setting and load resistor. I adde gain setting resistor to the second opamp.

hartytp, 2019-12-01:
For a 50 ohm load it’s just the conversion loss from the data sheet minus any compression isn’t it?

hartytp, 2019-12-01:
i vote we put something sensible here based on data sheet numbers and then test when the hw arrives and tweak as necessary for the v1.1 he

gkasprow, 2019-12-01:
ERA-2SM+ has 11dBm IP1 so if we drive the mixer with 10dBm minus 5dB conversion loss of the mixer we get 5dBm. This is 0.56Vp so we need roughly 2x gain to match the Stabilizer AFE range.

Closed 2019-12-01.

Thread 21 (2019-09-29):

IF notch filter

hartytp, 2019-09-29:
For higher bandwidth loops, a low-pass filter is often not a good option, since there isn't enough separation between the LO and the passband.

Can we have enough pads to allow us to have a passive RC low-pass filter followed by a single OpAmp notch filter please?

Let's aim to make the OpAmp fast enough to implement a 40MHz notch/bandstop filter.

gkasprow, 2019-11-30:
would such schematic implement all feasible filter schemes?
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

hartytp, 2019-12-01:
Thinking about this more, I think that having an active filter here is probably not necessary since we already have one on Stabilizer.

- Let's keep it simple and just have a fixed gain stage to match the mixer output to the +-1V range on Stabilizer
- Let's make sure that the OpAmp is fast enough to give >=30MHz unity gain bandwidth so that we we don't get too much phase lag at 3MHz
- Let's keep the pads to allow us to have an LC not filter to remove the carrier. Is it worth also having a second notch for the 3rd harmonic? LC filters should be DNP by default, use a coil craft package with a decent range of inductors so we can make notches for carriers up to ~50MHz
- This would allow us to e.g. lock a PZT via Stabilizer's output, and also take pounder's fast output (via the ADC SMA on Stabilizer) and hook that up to a fast lock (even just a simple P onto the laser current)

hartytp, 2019-12-22:
This is now basically a duplicate of #19

Closed 2019-12-22.

Thread 22 (2019-09-29):

output noise

hartytp, 2019-09-29:
FWIW the current design looks sub-optimal from a noise perspective. Maybe that's okay since we expect detector noise to always dominate? But, worth thinking about OpAmp/Johnson noise and making sure this doesn't accidentally limit system performance.

While we're on it, worth checking the usual things like bias-current offsets, self-heating effects on offset stability etc.

dnadlinger, 2019-10-06:
Regarding op-amps, I had suggested the OPA828/ADA4625, but that was under the assumption that
 - the target is ±10 V out (for which there isn't a good reason for fast loops),
 - we want a non-BJT input stage to hot have to worry about DC offset drifts due to rectified RF,
 - 1/f noise and offset drifts are worth thinking about, and
 - we are using a kΩ-level load on the mixer (which is good for performance when used as a saturated phase detector for fibre noise cancellation, but might not be appropriate for 10 MHz IF bandwidth).

There are probably better choices for a more general, wide-band demodulator.

hartytp, 2019-10-06:
Before finalizng the OpAmp choice, it would be worth simulating a LO notch filter for a realistic max frequency. Say, 40MHz (much higher than that and simple passive filtering will do the job)?

I suspect that something like an AD8021 would do a good job, but needs checking.

dtcallcock, 2019-10-08:
Can I leave it to one of you guys to pick something as I'm not as up on the latest opamp fashions and trends.

gkasprow, 2019-11-30:
So, what type of the filter you want me to simulate? Do you really want to build 40MHz filter using opamps?

hartytp, 2019-12-01:
> So, what type of the filter you want me to simulate? Do you really want to build 40MHz filter using opamps?

No

hartytp, 2019-12-01:
A fast FET amp sounds good here.

Closed 2019-12-22.

Thread 23 (2019-09-29):

power budget

hartytp, 2019-09-29:
definitely needed since this AFE will burn non-negligible power

gkasprow, 2019-11-30:
The power budget is here
[Phaser_Power_Pounder.xlsx](https://github.com/sinara-hw/Pounder/files/3907667/Phaser_Power_Pounder.xlsx)
The module will consume roughly 5.2W of power

gkasprow, 2019-12-01:
The power budget includes dual attenuator and amplifier variant.

gkasprow, 2019-12-29:
Updated power budget
[Phaser_Power_Pounder.xlsx](https://github.com/sinara-hw/Pounder/files/4008355/Phaser_Power_Pounder.xlsx)

Closed 2019-12-29.

Thread 24 (2019-09-29):

power amp

hartytp, 2019-09-29:
Do we really need the power amp? Is this a niche use-case better served by a packaged amp near the load?

If we do need it, someone needs to check the design carefully. Power levels appropriate, power handling of switches etc, thermal management, etc. Also make sure the PA is powered down by default. Maybe have an LED to indicate when it's active?

hartytp, 2019-09-29:
NB any coupling between the RF output and input can give offsets on the lock signal. Since we have a lot of gain here, we'll have to be very careful about decoupling the two halves of the circuit.

gkasprow, 2019-09-29:
Shall I add a shielded cage for Rx part?

dnadlinger, 2019-10-06:
I've opened #27 regarding shielding.

dtcallcock, 2019-10-08:
Ok, let's scrap this.

gkasprow, 2019-11-30:
I removed the power amp. it is still on the schematics but disabled with compile mask so you can still change your mind

Closed 2019-11-30.

Thread 25 (2019-09-29):

test points, LEDs, 0R etc

hartytp, 2019-09-29:
Please can we have lots of LEDs: all power lines, lock detect signals, front plane, etc

Also, lots of test points, covering all useful signals (inc SPI, I2C, power lines, etc).

I also find it useful to have a smattering of 0R resistors to make it easier to disconnect parts of the circuit during debugging (e.g. on digital lines, RF lines, etc).

dtcallcock, 2019-10-08:
Some of the testpoints and power LEDs got dropped when copying the power rail stuff over from Urukul.

gkasprow, 2019-11-30:
added testpoints, 0R on RF lines, LEDs for all rails.

Closed 2019-11-30.

Thread 26 (2019-09-29):

check supplies

hartytp, 2019-09-29:
drop out voltages, etc. Also check against Urukul that we're not using regs which we've had stability problems in the past.

gkasprow, 2019-11-30:
we use exactly the same ICs as in Urukul.
I will do PI analyzis after routing

gkasprow, 2019-11-30:
we use exactly the same ICs as in Urukul.
I will do PI analyzis after routing

Closed 2019-12-01.

Thread 27 (2019-10-06):

Shielding and RF out/in crosstalk

dnadlinger, 2019-10-06:
As pointed out in #24, with Pounder we have a coherent receiver on the same PCB as (potentially) the sender power amp, so avoiding crosstalk from the RF (LO) output to the input signal path is a concern – we care about DC stability for this. Shielding from external EMI is also a concern.

Having previously been bitten by this (trap RF coupling into PDH locks of nearby frequency), I would probably tend to go overboard here in typical physicist-who-has-opened-expensive-test-equipment fashion. Unless someone has a certain spec in mind here, though, perhaps the way to go here is simply to pay attention to separation/compactness in layout, and add provisions for a shielding can for the input side of things.

dtcallcock, 2019-10-08:
> Unless someone has a certain spec in mind here, though, perhaps the way to go here is simply to pay attention to separation/compactness in layout, and add provisions for a shielding can for the input side of things.

I like this plan.

dhslichter, 2019-10-10:
I would argue that a shielding can on the *output* side would also be beneficial.  Since we are talking about frequencies above a few MHz, cans can be pretty effective, and don't have to be that expensive either.  Another "old fashioned" way to do this is to put the input and the ouput on opposite sides of the board (if there is space).  You do have to ensure then that you are choosing different lock frequencies for neighboring Pounder cards.

gkasprow, 2019-11-30:
I added cages but we have very little space so it's possible that only Rx part would be shielded.

Closed 2019-11-30.

Thread 28 (2019-10-06):

Mixer IF load

dnadlinger, 2019-10-06:
The mixer IF output is currently 50Ω-terminated at AC, with a corner frequency of ~ 1 kHz, and 4.7kΩ at DC:

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

I guess this might have been a misunderstanding based on the diplexed setup I had suggested elsewhere for optimising the voltage/phase slope at DC (for which a more appropriate corner frequency would be a MHz or so).

Perhaps we should just go with a simple 50 Ω load by default, though, as this is definitely the most universal (if slightly suboptimal) option across all use cases, and should avoid confusion.

dtcallcock, 2019-10-06:
The load @dnadlinger suggested from https://doi.org/10.1109/FCS.2011.5977868 was:

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

This is based on [this paper](https://doi.org/10.1109/FREQ.1977.200168) and [this one](https://arxiv.org/abs/physics/0608211).

dtcallcock, 2019-10-06:
> Perhaps we should just go with a simple 50 Ω load by default

I think this is a reasonable approach. We should have the pads to allow people to realize the above topology though.

dnadlinger, 2019-10-06:
@dtcallcock: Thanks for collecting the links. Yes, having the pads is probably a good idea. If we include two parallel pairs of pads for a series-Z connection to ground (like the RC in the above), people could also put on passive notch filters at f/2f like in the old PDH literature. (I've never tried to measure whether that's actually a good idea.)

gkasprow, 2019-11-30:
I implemented 50R by default. The topology from the paper can be implemented as well.

gkasprow, 2019-11-30:
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

Closed 2019-12-01.

Thread 29 (2019-10-06):

Split DDS DAC power planes

dtcallcock, 2019-10-06:
From the [datasheet](https://www.analog.com/media/en/technical-documentation/data-sheets/AD9959.pdf):

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

Probably worth doing given we are [sensitive to crosstalk](https://github.com/sinara-hw/Pounder/issues/27).

gkasprow, 2019-10-07:
Do you mean adding FB + Caps for every AVDD group?

hartytp, 2019-10-07:
"though shalt have only one ground before thee"...

gkasprow, 2019-10-07:
OK, on the devkit the supplies are separated so I will follow that approach.

gkasprow, 2019-11-30:
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

Closed 2019-11-30.

Thread 30 (2019-10-06):

Stabilizer firmware support

dtcallcock, 2019-10-06:
A bare-bones set of ethernet commands to run Pounder may be:
- Set PGA gain
- Read CPU ADC
- Read power detectors using CPU ADC and convert to power (assuming datasheet specified component behavior - doesn’t need to be calibrated)
- Select oscillator input for DDS
- Enable clock multiplier with 4x, 5x, or 50x (for using 100MHz onboard oscillator or 10/100/125MHz ext ref)
- Set digital attenuators
- Set the RF output switches
- Write general DDS register
- For each DDS channel:
	- Enable/disable output
	- Set amplitude
	- Set phase
	- Set freq

Anything else that would be needed off the bat?

jordens, 2019-10-12:
* LEDs
* Readback of DDS register, attenuator state

hartytp, 2019-12-01:
Not a hw issue

jbqubit, 2019-12-01:
Updated [wiki ](https://github.com/sinara-hw/Pounder/wiki) to reference repository for firmware.

Closed 2019-12-01.

Thread 31 (2019-10-07):

ERA2SM (LO amp)

dtcallcock, 2019-10-07:
-At <200MHz the gain of the ERA2SM is typically 16dB, not 15dB.

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

Should we change 9dB pad (IC23) before to a 10dB pad to maintain 11dB into mixer and fix the annotations?

dtcallcock, 2019-10-07:
The bias resistor should be 88.7R if you're using E96.

dtcallcock, 2019-10-08:
> Should we change 9dB pad (IC23) before to a 10dB pad

I mean change from 1dB to 2dB.  The confusion was because the symbol sayd '9dB' on it for some reason.  This is a problem with both IC23 and IC17.

gkasprow, 2019-11-30:
changed to 2dB

Closed 2019-11-30.

Thread 32 (2019-10-07):

DC block caps

dtcallcock, 2019-10-07:
- 2.2uF caps are used everywhere except for C26 (10nF).
- What part number are these?  I could imagine some general purpose 2.2uF ceramics having pretty poor RF performance at 200 MHz.
- The section between C13 and C25 is floating.  Can one of these be default populated by 0R?

dtcallcock, 2019-10-08:
[ATC 530L] are 100nF broadband DC block caps specced from 16kHz to 18GHz.  A little bit pricey ($0.5) but guaranteed to work nicely.

dtcallcock, 2019-10-08:
C95 also needs to be the same type as our agreed DC block cap.

jordens, 2019-11-27:
And the ACG caps on the attenuators also need to be the same as the signal path ones.

jordens, 2019-11-27:
IMO 2.2uF is really large. Going that low in frequency (a) competes with what Stabilizer could do in baseband without downconversion, certainly for the LO paths, (b) makes properly biasing the amplifiers harder, and (c) risks having high ESL due to design and the large capacitance-to-volume ratio and correspondingly worsening the high frequency performance above the series resonance.

gkasprow, 2019-11-30:
we can use two caps connected in parallel: 10nF and 2.2u.
with 1nF would be hard to go down to a single MHz range. 10nF at 1MHz is 16Ohm.
If we go for these wideband caps (but their availability could be an issue) we still get Z=1.6Ohm

hartytp, 2019-11-30:
I always worry about resonances when paralleling cape. Might be worth simulating first

gkasprow, 2019-11-30:
the ATC530 is available everywhere. One must skip ATC and simply type 530L104KT16T
Let's use them.

gkasprow, 2019-11-30:
I even have them in the libs :)

jordens, 2019-11-30:
If you really want to go to those low DDS frequencies, some thought should also go into biasing chokes and decoupling and potential crosstalk through that.

Closed 2019-11-30.

Thread 33 (2019-10-07):

ERA3SM (output amp)

dtcallcock, 2019-10-07:
- Power annotation just before amp is wrong (should be -15dBm).
- We are using 100R to bias but [datasheet](https://www.minicircuits.com/pdfs/ERA-3SM+.pdf) suggests 107R as optimum for 7V operation.

gkasprow, 2019-11-30:
done
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

gkasprow, 2019-11-30:
@dtcallcock there was misleading "9dB" text on the 1dB attenuator symbol.
So we have -5dBm power level. Together with 23dB of gain it gives 13 dBm at the output. So T pad should have 4dB so we get 13dBm at the ERA-3SM+ output.

gkasprow, 2019-11-30:
We can connect two 2dB attenuators to save one BOM line.

gkasprow, 2019-11-30:
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

gkasprow, 2019-11-30:
since we decided to scrap power amp, this is not an issue anymore

Closed 2019-11-30.

Thread 34 (2019-10-08):

Front panel

dtcallcock, 2019-10-08:
Currently:

- 2x SMA in
- 2x SMA out
- 1x SMA ext CLK in

How about adding:

- 2x CPU ADCs (unused JADC5 P & N) to MCX for monitoring photodiodes (for example the NIST doublers have a built-in photodiode that monitors the output power)?
- Some user LEDs (if we have any spare IO from CPU or extenders)?

dtcallcock, 2019-10-08:
>Some user LEDs

From: https://github.com/sinara-hw/Pounder/issues/18#issuecomment-536330465

> it would also be great to have LEDs to indicate low/high power levels.

dtcallcock, 2019-10-08:
Right now there is a barrel connector (J6) on the schematic and a Molex connector on the back.  Are these for if the [power budget](https://github.com/sinara-hw/Pounder/issues/23) exceeds what Stabilizer can supply?

hartytp, 2019-10-08:
The barrel connector is useful IMHO because we couldn’t fit one on the stabilizer FP and one doesn’t always want to use PoE

Not sure I see any use for the rear molex since stabilizer has one already

dtcallcock, 2019-10-08:
So this would essentially be the same front panel as Stabilizer but with the ethernet+usb replaced by power barrel + ext_clk SMA.  Looks a bit tight but I'm happy with that if it can be made to work.

jordens, 2019-11-27:
Adding a barrel connector to the 5 SMA would be painful. If you put these in a rack and don't want to use PoE, can't people just wire up the Stabilizer power input in the crate? Or use VHDCI Carrier to power many Stabilizer If that's the goal. If they are not in a rack but in a separate enclosure, the back connector would stick out anyway and be easily accessible.

gkasprow, 2019-11-30:
two MCX is not a problem. Route it directly to the CPU ADC? These are 0-2V048 inputs.
more LEDs are also OK, I need I2C expanders anyway

Closed 2019-11-30.

Thread 35 (2019-10-08):

Ext Clk transformer

dtcallcock, 2019-10-08:
Isolation transformer [T2-1T](https://www.minicircuits.com/pdfs/T2-1T.pdf) only goes to 200MHz.  We want to be able to drive this at 500MHz to avoid using the DDS internal multiplier.

It looks like [ADT2-1T-1P+](https://www.minicircuits.com/pdfs/ADT2-1T-1P+.pdf) will do the job.

Should also check the following 100nF caps (C105 & C195) behave reasonably at 500MHz.

gkasprow, 2019-11-30:
done. I changed the termination resistor to  100R.
Capacitor Z at 500MHz is [0.8R](https://ds.murata.co.jp/simsurfing/mlcc.html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)

Closed 2019-11-30.

Thread 38 (2019-10-08):

DDS decoupling caps

dtcallcock, 2019-10-08:
On the [eval board](https://www.analog.com/media/en/technical-documentation/evaluation-documentation/57418637811849AD9959_pcb_0.pdf) there is a 10uF as well as 2x 100nF for each power (AVDD0, AVDD1, AVDD2, AVDD3, CLK_VDD, DVDD, DVDD_IO).  Should we beef up our decoupling to match?

gkasprow, 2019-11-30:
OK, done

Closed 2019-11-30.

Thread 39 (2019-10-08):

DDS loop filter

dtcallcock, 2019-10-08:
Schematic matches [eval board](https://www.analog.com/media/en/technical-documentation/evaluation-documentation/57418637811849AD9959_pcb_0.pdf) with 698R in series with 680pF to GND.  This seems wise.

[Datasheet](https://www.analog.com/media/en/technical-documentation/data-sheets/AD9959.pdf) though says "Typically, the network consists of a 0 Ω resistor in series with a 680 pF capacitor tied to AVDD."  Should we add non-populated capacitor pad to AVDD in case we find it better to follow the datasheet recommendation?

gkasprow, 2019-11-30:
I assume it should be connected to CLK_VDD. We don't have AVDD anymore since I splitted the power rails.

Closed 2019-11-30.

Thread 40 (2019-10-08):

DDS output filter

dtcallcock, 2019-10-08:
Right now specified as DC to 160MHz.

Presumably this is an [LFCN-160](https://www.minicircuits.com/pdfs/LFCN-160+.pdf)?

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

An alternative part would be [ULP-216+](https://www.minicircuits.com/pdfs/ULP-216+.pdf).

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

Would give the same bandwidth but quite a bit better attenuation of the image frequencies.  More expensive and much larger footprint though so perhaps not worth it.

jordens, 2019-11-27:
Not worth it IMO. Have the user clean inputs and outputs with custom bandpasses if there is are problems with aliases.

gkasprow, 2019-11-30:
Yes, it is LFCN-160+ now. Before there was just a placeholder.

Closed 2019-11-30.

Thread 41 (2019-10-08):

AD8363 VTGT & C_HPF

dtcallcock, 2019-10-08:
The resistive divider sets this to 1.33V currently.

From the [datasheet](https://www.analog.com/media/en/technical-documentation/data-sheets/AD8363.pdf):

>Most of the characterization information in this data sheet was collected at VTGT = 1.4 V. Voltages higher and lower than this can be used; however, doing so increases or decreases the gain at the internal squaring cell, which results in a corresponding increase or decrease in intercept. This in turn affects the sensitivity and the usable measurement range. Because the gain of the squaring cell varies with temperature, oscillations or a loss in measurement range can result. For these reasons, do not reduce VTGT below 1.3 V.

Unless this was intentional, I think we should just stick with 1.4V

dtcallcock, 2019-10-08:
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

If we want to go down to 1MHz, then we want a 100kHz pole.  Therefore 270pF would seem more appropriate than the current 0pF (DNP)

gkasprow, 2019-11-30:
done

Closed 2019-11-30.

Thread 42 (2019-11-27):

harmonize transformers

jordens, 2019-11-27:
* T2-1T+
* ADT1-1WT+
* ADT1-1+

Maybe this can be simplified. I'd consider going for the cheaper/simpler T1-1xx style everywhere. And maybe the T2-1 things won't be needed at all if the PGA becomes a step attenuator plus fixed amplifier.

On TR1 I also think it's wrong (has 50R diff termination but 2:1 ratio from a 50R SE source).

gkasprow, 2019-11-30:
So far we have:
4x ADT1-1WT+ at the DDS outputs
ADT2-1T+ as a clock input isolator. The ADT1-1WT+ should work even though it is 75Ohm
ADT1-1WT+ at the RF output
ADT2-1T+ at the PGIA output
ADT1-1+ replaced by TC2-1TX+ at the PGIA input

hartytp, 2019-12-22:
cf phaser balun choices

gkasprow, 2019-12-29:
After some optimization we have
DDS output, RF output:  ADT1-1WT+, 75 Ohms 0.4 to 800 MHz 1:1 RF Transformer
Ext CLK IN:  ADT2-1T+, 50 Ohms 0.4 To 450MHz 1:2 RF Transformer
FB IN:  TC2-1TX+, 50 Ohms 3 to 300MHz 1:1 RF Transformer
Can we replace the clock input transformer with  ADT1-1WT+ ? I would terminate it with 50Ohm instead of 100R

jordens, 2019-12-29:
fine with me.

hartytp, 2019-12-29:
> Can we replace the clock input transformer with ADT1-1WT+ ? I would terminate it with 50Ohm instead of 100R

Fine by me. You loose a bit on signal amplitude but gain on the bw which is equally important assuming the clock is driven by a square-wave source.

dtcallcock, 2020-01-05:
> FB IN: TC2-1TX+, 50 Ohms 3 to 300MHz 1:1 RF Transformer

There is no data on how this will work down at 1MHz. Do we expect this to be a problem?  Is there a reason not to use [TC1-1TX+](https://www.minicircuits.com/pdfs/TC1-1TX+.pdf).  It's the same package but 0.4-500MHz.

gkasprow, 2020-01-05:
changed to TC1-1TX+

Closed 2020-01-05.

Thread 43 (2019-11-27):

power input

jordens, 2019-11-27:
Why is there a separate power input again? Can't Stabilizer power this with its ~20W available?

hartytp, 2019-11-27:
I’ve found it useful in other designs to have a fp barrel connector, but there isn’t room on stabilizer. So this can be used to power both stabilizer and the afe

jordens, 2019-11-27:
Can you elaborate why there is no easy way to power Stabilizer from its rear power connectors or EEM in these circumstances?
And is it reasonable to tailor the design of Pounder so that Stabilizer can be powered?
#34 for front panel problems with 5 SMA and one barrel connector

hartytp, 2019-11-27:
In some of our racks the rear of Stabilizer isn't easily accessible and powering from an EEM/PoE isn't convenient.

> And is it reasonable to tailor the design of Pounder so that Stabilizer can be powered?

I wouldn't call this tailoring the design. Point is just that if there is space on the FP so we can easily add the connector then it's a nice convenience feature (this is what we did on our current sense AFE and it's been useful). It there are good reasons not to do it (e.g. lack of space due to all those SMAs) then it's fine to drop it. It's not a big deal either way.

jordens, 2019-11-27:
Let's remove the power connectors from the back and make optimal use of the front panel real estate.

gkasprow, 2019-11-30:
@jordens The Stabilizer already have rear power connector, so there is no need to have it on Pounder as well.
To fit DC jack to the front panel, we would have to switch to MCX connectors, at least for the external clock input.

jordens, 2019-11-30:
I'd be a bit worried for ultimate phase stability with rotating connectors like mcx. But I don't have any data. It's a bit too much connector type diffusion for me. My choice would be to leave this all sma and omit front panel power in favor of the two existing alternative powering options.

hartytp, 2019-11-30:
I’m fine with that

gkasprow, 2019-11-30:
OK, done

gkasprow, 2019-11-30:
this is proposed connector layout
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

Closed 2019-11-30.

Thread 44 (2019-12-22):

review

hartytp, 2019-12-22:
@gkasprow @dtcallcock what's the status of this project? Are we waiting for a review by @dtcallcock, or are we waiting or @gkasprow to finish updating the project? I've lost track...

hartytp, 2019-12-22:
okay, I think almost all issues have been implemented. We need clarity from someone on what input power ranges we want to support, but other than that it looks like we should be able to produce another schematic RC relatively quickly from here.

dtcallcock, 2019-12-22:
I was waiting on a new schematic after that slew of issue activity about a month ago.  Let us know if there is anything you still want to discuss though @gkasprow

gkasprow, 2019-12-22:
It was on hold due to Booster and  Phaser. We will finish it after Xmass

hartytp, 2019-12-29:
Nothing to do here. Let's open a new issue when there is a new RC that fixes all current issues...

Closed 2019-12-29.

Thread 45 (2019-12-30):

rc0 review

gkasprow, 2019-12-30:

gkasprow, 2019-12-30:
@hartytp the newest release is [here](https://github.com/sinara-hw/Pounder/releases/tag/v1rc0)

hartytp, 2019-12-31:
- [ ] what are the components in grey? e.g. the PGA? Are those a population variant? Can we just delete them since I don't see us ever wanting them and I'd like to avoid filling the design up with kruft

hartytp, 2019-12-31:
the OpAmps draw a decent amount of current, which comes directly from the P/N 12V rails. That will dissipate a decent amount of heat. Worth using the 7V5 SMPS as a source for the 5V rail?

hartytp, 2019-12-31:
@gkasprow I've completed my review.

Looks really nice!

gkasprow, 2019-12-31:
The Opamps consume max 14mA, which gives 28mA in total. With 7V losses on LDOs it gives us  2x 200mW.
SMPS would give +/-6V which would be converted to +/-5V by LDOs. SMPS losses would be roughly 300mW including quiescent power (1W SMPS have roughly 60% efficiency + 0.25W of idle power) + LDO losses of 2x28mW. So instead of 400mW we would have 360mW with increased EMI, cost and complexity. Not worth the effort IMO.

hartytp, 2019-12-31:
Can you post an updated RC PDF at some point so I can sign off on it? Thanks!

Closed 2019-12-31.

Thread 46 (2019-12-31):

schematic cosmetics

hartytp, 2019-12-31:
- [x] nit: why does the DDS SPI bus traverse the schematic rather than being neatly located near its end point?

hartytp, 2019-12-31:
stray net
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

hartytp, 2019-12-31:
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

There is no PGA. "Demodulation"?

hartytp, 2019-12-31:
I find this filter response curve a little confusing since it's not clear which filter it corresponds to amongst the forest of DNPs. Let's scrap it

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

hartytp, 2019-12-31:
Why do only two of the attenuators have this termination and not the other two?

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

hartytp, 2019-12-31:
Let's add an annotation to remind ourselves what this transformer is for (e.g. "remove R? and R? to isolate output")
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

hartytp, 2019-12-31:
missing spaces in annotation
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

hartytp, 2020-01-09:
>  nit: why does the DDS SPI bus traverse the schematic rather than being neatly located near its end point?

Nit: this wasn't fixed...

Closed 2019-12-31.

Thread 48 (2019-12-31):

FB In GND option

hartytp, 2019-12-31:
let's add DNPd 0R resistors to allow the FB inputs to be grounded to the PCB ground in case that's something that becomes useful at some point.

hartytp, 2019-12-31:
same for clock input

gkasprow, 2019-12-31:
done. I assume we DNP them.

Closed 2019-12-31.

Thread 49 (2019-12-31):

annotate power levels

hartytp, 2019-12-31:
Please can we have clear annotations on the schematic top page for the input/output power ranges?

hartytp, 2019-12-31:
also annotation clock input power range (NB it's only a 1V8 supply so can't take that much power)

gkasprow, 2019-12-31:
done.

hartytp, 2020-01-09:
The annotation says the clock inputs can take 2.5Vpp. Isn't that a little high? Or is the balun loss really that bad?

Closed 2019-12-31.

Thread 50 (2019-12-31):

fancy capacitors

hartytp, 2019-12-31:
didn't we agree not to use fancy rf caps?

gkasprow, 2019-12-31:
Well, my understanding was that we need to use them to avoid assembly variants.

gkasprow, 2020-01-08:
Is there anything to fix? Can we go for production

hartytp, 2020-01-08:
@gkasprow can you post an updated schematic with all fixes implement so we can all sign off?

gkasprow, 2020-01-08:
[done](https://github.com/sinara-hw/Pounder/releases/tag/v1.0rc1)

Closed 2020-01-08.

Thread 51 (2019-12-31):

consolidate rf amps

hartytp, 2019-12-31:
Can we just use MAR-8A+ everywhere instead of using ERA-2SM as well? This would save a BOM line.

gkasprow, 2019-12-31:
We can. Either we operate it with strong feedback or add an input attenuator.
MAR8 has very high gain or >30dB, we need 7dBm so the input signal would have to be attenuated by 20dB.

hartytp, 2019-12-31:
Well it’s not a big deal and we can keep things as they are if it’s a problem, just nice to keep the Bom short where we can

I think the attenuator is fine since we won’t be thermally limited with a nf of 23dB when using the dds pll. I’m any case the rf input has an attenuator that must be used with large signals so I don’t think the lo will limit.

Feedback fine by me if you prefer.

I’ll leave the choice (do nothing, change amp and add attenuator/fb) to you.

gkasprow, 2019-12-31:
I'd leave it as it is now. The MAR-8A+ has large gain variation vs frequency

hartytp, 2019-12-31:
@gkasprow if we're reducing the RF power anyway, would it make sense to use 2xERA-2SM? It's a slightly nicer amp and will do both jobs AFAICT.

Anyway, feel free not to bother, just throwing it out there...

gkasprow, 2020-01-01:
double ERA-2SM will significantly increase power consumption

Closed 2020-01-01.

Thread 53 (2019-12-31):

input LPF

hartytp, 2019-12-31:
Let's populate C60A by default to give a sensible LPF response. @dtcallcock any preference as to cut-off frequency?

gkasprow, 2019-12-31:
done

dtcallcock, 2020-01-05:
Probably something that's comfortably above the 500kHz LPF response of the Stabilizer servo.

What did you go for @gkasprow ?

gkasprow, 2020-01-05:
At the moment there are 9k1 and 180pF.
I can change it to 33p to get 530k

dtcallcock, 2020-01-05:
Sounds reasonable.  It's an 0805 package, so easy to change right?

gkasprow, 2020-01-05:
0603

dtcallcock, 2020-01-05:
Good enough.

gkasprow, 2020-01-05:
All  filter components are 0603, only bigger caps are 0805 to keep them C0G

Closed 2019-12-31.

Thread 56 (2019-12-31):

loop filter

hartytp, 2019-12-31:
why do the DDS loop filter default population options not follow the eval board?

gkasprow, 2019-12-31:
well, it does
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

hartytp, 2019-12-31:
Iirc the eval design connects the cap to a vcc

gkasprow, 2019-12-31:
Here is [a schematic ](https://www.analog.com/media/en/technical-documentation/evaluation-documentation/57418637811849AD9959_pcb_0.pdf)of eval board. The drawing above was copied from that pdf file.

hartytp, 2019-12-31:
hmmm...I was looking here https://www.analog.com/media/en/technical-documentation/evaluation-documentation/ad9958-ad9959-schematic.pdf

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

gkasprow, 2019-12-31:
OK, let's connect it to CLK_VDD then.

hartytp, 2019-12-31:
Okay, so there are two inconsistent versions of the schematic linked to from https://www.analog.com/en/design-center/evaluation-hardware-and-software/evaluation-boards-kits/eval-ad9959.html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

The one I posted matches the pin description
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

Also, IIRC it's more normal to decouple the CP output to Vcc than to GND so it makes more sense that way.

Maybe the schematic in the eval board data sheet is out of date?

hartytp, 2020-01-09:
If we're going to follow the eval board/pin description, shouldn't the resistors be 0R?

gkasprow, 2020-01-15:
OK, let's make it 0R
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

Closed 2020-01-15.

Thread 57 (2019-12-31):

dds supply decoupling

hartytp, 2019-12-31:
are we happy running the DDS analog and digital supplies from the same LDO with only a FB to decouple? I didn't see a clear recommendation on this. Feel free to close this issue if you're happy with the current situation @gkasprow

gkasprow, 2019-12-31:
The EVKIT has separate supply terminals for digital and analog lines.
I added more aggressive LC circuit for digital rails. I will replace the FB with regular 4.7uH, 17mOhm inductors

Closed 2019-12-31.

Thread 58 (2019-12-31):

TCM2/PWDN

hartytp, 2019-12-31:
Should we drive this pin? At least let's have a DNPd divider between Vcc and GND...

gkasprow, 2019-12-31:
I added compensation resistors as recommended in DS
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

hartytp, 2020-01-09:
Nitpick: why the pink highlighting in the screen clip?

Closed 2019-12-31.

Thread 59 (2019-12-31):

detector filter capacitors

hartytp, 2019-12-31:
@dtcallcock are you happy the power detector capacitor values are suitable for the frequency range you want to cover? What about the Vref etc?

dtcallcock, 2020-01-02:
> power detector capacitor values are suitable for the frequency range you want to cover?

They seem to match up with datasheet recommendations.

> What about the Vref etc?

Do you mean the fact that Vref is not connected to TCM1 or TCM2?  The datasheet seems to imply in some places that connecting TCM1/TCM2 to a specific voltage is optional but doesn't say what you should do with them (ie. leave floating?) or what the implications are.  I'd be tempted to add an unpopulated potential divider between Vref and GND for each as risk mitigation.

Closed 2020-01-06.

Thread 60 (2019-12-31):

P/N 5V LDO lockup prevention diodes

hartytp, 2019-12-31:
78/79 LDOs are prone to lockup when used with high Iq OpAmps.

- [x] while we're at it, should they have a 10uF tantalum output capacitor?

gkasprow, 2019-12-31:
The datasheet says nothing about output caps. They only specify 0.1uF. The caps cannot have too low ESR. 78/79 will for sure oscillate with too high capacitances with low ESR, for example, 4.7u X7R. I can add high ESR tantalum, but I'm not sure they are needed.
I added the diodes.
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

Closed 2019-12-31.

Thread 63 (2019-12-31):

run PI sim

hartytp, 2019-12-31:
(if only to check power margin on LDOs etc)

gkasprow, 2019-12-31:
Setting up the PI analysis takes a few hours of work so I do it only for complex circuits or critical rails. Here, we are copying power supply from already tested designs. I don't think it is necessary in this case.

hartytp, 2019-12-31:
Ok fair enough

Please can you
- [ ] add a power budget to the schematic
- [ ] confirm that no rail exceeds its max current

Then we can close

hartytp, 2020-01-09:
The power budget says that the 5V0A rail can draw up to 145mA, but the LT1761 is only a 100mA regulator...replace with a 3045 (thereby removing a BOM line)?

hartytp, 2020-01-09:
All other rails look fine (we're generally using 3A LDOs for rails drawing 100mA or so!).

hartytp, 2020-01-10:
NB if we add a new pre-amp we'll need to check the power budget on that rail...

gkasprow, 2020-01-15:
good catch. Fixed
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

hartytp, 2020-01-15:
Did you mean to connect pins 1 and 2?

gkasprow, 2020-01-16:
I did it already.

Closed 2020-01-15.

Thread 65 (2019-12-31):

OSC1 tuning

jordens, 2019-12-31:
Add a testpoint to OSC1 pin1 and a DNP 0R jumper plus two stage 10 kHz RC lowpass components to connect to DAC_O1_OUT1 from Stabilizer. And make R167/R168 a solderable ~0603 size.

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

gkasprow, 2019-12-31:
added
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

hartytp, 2020-01-09:
Nitpick, but would it be better to move the tp to the other side of R73 (close to the osc pin)?

Closed 2019-12-31.

Thread 66 (2019-12-31):

Panel

gkasprow, 2019-12-31:
Is the panel annotation OK?

hartytp, 2019-12-31:
- [ ] I didn't see a hw revision number
- [ ] assuming people have ideas about what the LEDs will be used for, it might be nice to label them by function
- [ ] I'd probably use In/Out rather than RF/FB as I think that's clearer
- [ ] For the ADC just just use ADC0 and ADC1 rather than P/N?

Otherwise LGTM.

gkasprow, 2020-01-01:
the HW rev is on the very bottom

gkasprow, 2020-01-01:
What LED functions can we have for Pounder?
Maybe Lock status? Detector signal level indication,
LED0, LED2, LED 4 are green
LED1, LED3, LED5 are red

dtcallcock, 2020-01-02:
Given the Stabilizer LEDs are labeled L0-3, should the Pounder ones be labeled L4 onwards?  Or at least something that won't lead to ambiguities.

> Lock status

Wouldn't that be one of the Stabilizer LEDs as usual.

> Detector signal level indication

Sure, that could be useful.

gkasprow, 2020-01-05:
LEDs are labeled L4-L9. Let's leave them as they are. Panel sticker can be laser-cut and added easily later on.

Closed 2020-01-05.

Thread 67 (2020-01-02):

Floating section

dtcallcock, 2020-01-02:
The circuit node containing R12+R17 is floating at DC.  Probably not a big deal but I thought this was generally to be avoided. If so, C7 could be omitted?

gkasprow, 2020-01-05:
OK, I removed C7

Closed 2020-01-05.

Thread 68 (2020-01-09):

question: output power levels

hartytp, 2020-01-09:
@dtcallcock @dnadlinger Maybe I've forgotten our original discussion on this, but what was the decision about the modulator RF output power level? Did we want a pre-amp there to boost this up to ~10dBm (enough to drive a nice resonant EOM) or are we fine committing to using an external amp?

Maybe it's too late to change this now...but I was curious.

dnadlinger, 2020-01-10:
I don't mind either way, and haven't been following the discussion.

dtcallcock, 2020-01-10:
Yes, I thought we had decided to scrap the 'power' amp (LHA-13HLN) and use a low power amp that's already on the BOM.  -6dBm max output is a bit weedy.

The ERA-2SM will work nicely as it has +16 dB of gain so will let us run up to +10dBm.

Sorry I didn't catch this earlier.  Is it too late to add @gkasprow  Not the end of the world if it is.

hartytp, 2020-01-10:
:+1: other than that all happy to close this design round?

gkasprow, 2020-01-15:
For this reason, I kept it under the compile mask. I can add it easily. I added 0R bypass resistor so one can keep the amplifier DNP

gkasprow, 2020-01-15:
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

Closed 2020-01-15.

Thread 69 (2020-01-09):

rc2

hartytp, 2020-01-09:
Completed my review of rc2. Looks good!

#63 needs to be resolved. The other open issues are non-critical as far as I'm concerned...

dtcallcock, 2020-01-10:
Annotation at C82 is -16dBm.  Should be -26dBm.

dtcallcock, 2020-01-10:
Should there be some cool logos on the board?

Other than that, I also think it looks great.

dhslichter, 2020-01-10:
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

dhslichter, 2020-01-10:
Make some line art of this guy.  He'd be pleased to be on the board :)

gkasprow, 2020-01-15:
is that OK?
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

hartytp, 2020-01-17:
@gkasprow did you really take @dhslichter's comment seriously???? Can we scrap that plz?

On a more important note, I've seen jumpers like this lead to GHz-frequency oscillations before due to added input-output coupling
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

gkasprow, 2020-01-17:
Did U see the physical layout?
I can use bigger footprint that woulf not change amplifier pads distance. We can also scrap it. I thought that you dont need this amp.

Pozdrawiam,
G.Kasprowicz

________________________________
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

hartytp, 2020-01-17:
> Did U see the physical layout?

No. I don't have altium right now and you didn't include the layout in the pdf. If you're happy with this then it's fine by me.

> I thought that you dont need this amp.

We will want this amp for pounder (not for phaser, because it's a different application in our lab).

Closed 2020-01-15.

Thread 70 (2020-01-10):

TCM Input impedances

dtcallcock, 2020-01-10:
>The TCM1 and TCM2 pins have high input impedances, approximately 5 kΩ and 500 kΩ, respectively

But actually TCM1's 5k is not high compared to R59/R61.

How about using R59 = 9.76k, R61=4.99k?  Though probably don't need E96 precision given the 'approx' in front to the 5k pin impedance.

R66 could be changed to 31.6k to compensate for TCM2 impedance.

gkasprow, 2020-01-15:
Vref can source up to 4mA, so we can lower the dividers 10x
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

Closed 2020-01-15.

Thread 71 (2020-01-10):

Shielding Can

dtcallcock, 2020-01-10:
I'm not sure the current shielding cans are optimal.  The main problem with PDH locks in output->input crosstalk.  Therefore to be useful I think they should cover the input only.  This is also the part of the circuit most sensitive to pickup.

If it's a big job to alter we can always make measurements on v1.0 to see if it's worth the effort.

gkasprow, 2020-01-15:
It would be a lot of work to cover only Rx part. Especially when I added the PWR amp.
What I can quickly do is to move the Rx parts to the bottom layer, especially Rx transformer and PWR stage that can generate EMI

dtcallcock, 2020-01-15:
To be clear, you mean move this stuff to the other side of the PCB?

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

gkasprow, 2020-01-15:
no, just PWR amp and balun. They are close to the input

gkasprow, 2020-01-15:
ICs don't generate much coupling

dtcallcock, 2020-01-15:
Sounds like a reasonable compromise.

gkasprow, 2020-01-16:
I drafted the new release. I think it can go to production.

gkasprow, 2020-01-16:
How many pcs shall we produce?

dtcallcock, 2020-01-16:
> I drafted the new release. I think it can go to production.

Sounds good to me.

> How many pcs shall we produce?

I'd say 3 is a minimum.  @jordens will need one for gateware development, and then us and Oxford would want one each for testing (assuming @dnadlinger or @hartytp is interested in having a play).  Probably all 3 should go to @jordens to start with in case there is a bad board.

Whether you should make a few more on top of that depends on the price breaks you get for runs of this size.

dtcallcock, 2020-01-16:
Related: @jordens do you have Stabilizer v1.1 hardware available or do you need me to ship you one?

jordens, 2020-01-16:
I'm not going to rework boards.

jordens, 2020-01-16:
@dtcallcock I have a stabilizer 1.1. Can you port the current firmware to it?

dtcallcock, 2020-01-16:
> I'm not going to rework boards.

Exactly.  If you have more than one board you can put a bad board aside and use a different one instead of reworking\debugging the bad one.

dtcallcock, 2020-01-16:
> Can you port the current firmware to it?

No, I don't have anyone with those skills in my group yet.  How much work is involved?

jordens, 2020-01-16:
In the past the prototype fabrication has been consistent. It makes more sense to hold two boards at the Fab for possible reworks.

dtcallcock, 2020-01-16:
> It makes more sense to hold two boards at the Fab for possible reworks.

Then let's do that.

jordens, 2020-01-21:
@dtcallcock see quartiq/stabilizer#66

Closed 2020-01-15.

Thread 72 (2020-01-17):

output power annotation not correct

hartytp, 2020-01-17:
since we added a pre-amp
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

hartytp, 2020-01-17:
likewise
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

Closed 2020-01-20.

Thread 73 (2020-01-17):

output amp bias

hartytp, 2020-01-17:
why does this have different bias resistors to the other ERA?

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

hartytp, 2020-01-17:
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

gkasprow, 2020-01-20:
fixed

Closed 2020-01-20.

Thread 74 (2020-01-17):

PI with new pre-amp

hartytp, 2020-01-17:
@gkasprow to double check, after adding the two new pre-amps, did you...
- [x] update power budget
- [x] check the SMPS/LDO can supply sufficient current
- [x] check all traces are thick enough
- [x] think about coupling between the two channels and the fb/output paths

If so, please close. Thanks! Other than that looks good to go to manufacture as far as I'm concerned.

Closed 2020-01-20.

Thread 75 (2020-02-05):

PTH Hole broken

psyryczyk, 2020-02-05:
The PTH hole intersects the outline. This hole will be broken and exposed copper when milling.

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

gkasprow, 2021-01-23:
fixed
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

Closed 2021-01-23.

Thread 76 (2020-02-27):

SYNC_CLK to Stabilizer ETR/CHx timer input

jordens, 2020-02-27:
* I don't see how SYNC_IN is useful. Should have done thorough analysis in #55
* We should enable SYNC_OUT to the CPU for accurate software-demodulation (required for quartiq/stabilizer#80)
* This needs a timer channel input with external clocking capability to be used as counter
* Counting 125 MHz may or may not be doable with the stm32h7 (but should be checked) physically.
* Potentially interesting input topologies would be: TIMx_CHx or maybe better TIMx_ETR+internal asynchronous ETPS prescaler (/4 or /8)?
* From what I can tell it's not possible with the HRTIM. It would need to be a general purpose or advanced timer. Maybe HRTIM_EEVx though?
* If 125 MHz is too fast for a timer, the alternatives are (a) a discrete prescaler or (b) using one of the the reference clock outputs from Pounder (10 MHz from SMA only then) to a timer channel counter input on Stabilizer
* If prescaler, then consider possible prescaler phase measurement and compensation (deterministic closed loop phase)
* Better to use SYNC_CLK than SYNC_OUT b/c duty cycle?

gkasprow, 2020-08-17:
@jordens I plan a new release of Stabilizer. Which solution would be the most promising? An LVCMOS divider /8 would be fine?
Of course, I would have to change in Stabilizer design the IO pin assigned to this particular GPIO header pin. I can add such circuit to existing boards - I have one Stabilizer and one Pounder.
What do you mean by prescaler phase measurement and compensation? D you mean IC propagation delay? Why would we care about it since the STM32 input is not compensated.

jordens, 2020-08-24:
We use PA0 for DDS_RESET on Pounder v1.0. After we checked the max input frequency on PA0, I'd suggest connecting DDS_RESET to J10:11 (PG6) and SYNC_CLK (if needed through a /8 prescaler) to J10:18 (PA0). And on Stabilizer the PA0 wire should be cleaned up to and there should probably be some termination (series or AC parallel?).

gkasprow, 2020-09-01:
It's easier for me to add a prescaller and bypass option than to check max STM frequency, especially if it is undocumented and may not work with other production batches.

gkasprow, 2020-10-10:
@jordens I cleaned the PA0, the next action is to modify the pounder, right?

jordens, 2020-10-11:
Yes

jordens, 2020-10-12:
I checked the counter input. No external prescaler needed. Just

* connect DDS_RESET to J10:11 (PG6)
* connect SYNC_CLK to J10:18 (PA0) make sure that this 125 MHz signal gets to the CPU with correct level and decent termination/matching

ryan-summers, 2020-12-09:
The changes @jordens proposed above were manually completed by me on TS 38/20 0002. In addition to the changes mentioned above, I also removed R70 (to disconnect SYNC_IN from PA0).

I have run firmware and verified that the clock can be properly driven using this hardware configuration and this is sufficient for timestamping ADC samples.

Closed 2021-01-23.

Thread 77 (2020-03-21):

LT3045 output capacitance

hartytp, 2020-03-21:
CF https://github.com/sinara-hw/Urukul/issues/52

gkasprow, 2021-01-23:
I added another 22uF to outputs of both LT3045

Closed 2021-01-23.

Thread 78 (2020-04-01):

v1.0 testing

hartytp, 2020-04-01:
@gkasprow what's the status of production/testing for Pounder v1.0?

pkozakiewicz, 2020-04-01:
@hartytp We are just doing SMT assembly at the moment. I'll be able to bring those boards to Greg this week.

jordens, 2020-04-01:
@gkasprow It might be possible to get some basic testing firmware (i.e. set clock to XO, initialize DDS, output some frequency on all four channels) done so you can do the bulk of the hardware debugging within the next two weeks. If that helps you with the smoke-testing and catches some hardware issues early, it would be great to do. @ryan-summers would be working on that.

gkasprow, 2020-04-01:
Sure. For now, I can only check only power supplies.

hartytp, 2020-04-01:
Great! Thanks all for the update

ryan-summers, 2020-04-09:
@gkasprow I've implemented a custom firmware image for pounder bringup that will configure the AD9959 (DDS) to output waveforms on CH1-CH4 at various frequencies (CH1: 80MHz, CH2: 80.001 MHz, CH3: 90 MHz, CH4: 90.001 MHz).

This firmware communicates with the I2C GPIO expander on Pounder to power the on-board oscillator and select it for use by the DDS. There are a few indications:
1. **All Pounder LEDs** are illuminated - This indicates that communication with the GPIO expander over I2C was successful.
2. **Stabilizer LEDs 1-3** are illuminated - This indicates that a self-test of the DDS quad SPI interface passed.
3. **Stabilizer LED 0** is rapidly toggled (MHz range) if the device did not encounter any errors.
3. Regardless of (1) and (2), the respective waveforms are generated on CH1-CH4. If either (1) or (2) above did not pass,  these waveforms may or may not be present (either due to communication or clocking issues).

This firmware should be flashed identically to however you have flashed Stabilizer previously.

jordens, 2020-04-09:
NB: current master of cargo-flash+probe-rs support that chip and e.g. stlink-v3 nicely.

jordens, 2020-04-16:
@gkasprow do you have the completed board? Any first impression?

gkasprow, 2020-04-16:
Yes. I received it yesterday.
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

gkasprow, 2020-04-23:
the IC22 voltage is wrong. It is 6.3V instead of 7V

gkasprow, 2020-04-23:
the FB voltage is 0.696V

gkasprow, 2020-04-23:
OK, I assumed FB is 0.8V because the DS says it can work from 0.8V to 17V.
In fact, we have 0.7V. So the voltage divider is wrong.

gkasprow, 2020-04-23:
The R136 must be corrected. Instead of 5k6, there should be 4k7

jordens, 2020-04-29:
@gkasprow We [developed a testing firmware](https://github.com/sinara-hw/Pounder/issues/78#issuecomment-611549862) for you as discussed. Did you try that? Did you just check power supplies or will there be more testing on your end? TS seems to be about to ship these devices out but I have no idea how much testing they have seen.

gkasprow, 2020-04-29:
I managed to check the power supplies and fix one bug. Due to the very urgent and complex COVID-related project, I didn't do more. Hopefully, in a month I will come back to reality...

jordens, 2020-04-30:
@dtcallcock what do you think? We won't be able to dig very deep into hardware debugging.

dtcallcock, 2020-04-30:
I'm happy to just hit pause for a month until @gkasprow can do more testing if everyone else is.

jordens, 2020-10-28:
I'd like to push for v1.1.

We did some basic smoke testing and it works fine apart form the issues we submitted. Nothing surprising on a spectrum analyzer scan or on the quick-and dirty beat between two channels.

@dtcallcock @hartytp did you guys test and maybe characterized it a bit?

@gkasprow Do you want to fork an issue for R136?

hartytp, 2020-10-28:
I'm not going to get around to looking at this any time soon I'm afraid. Not sure about @cjbe or @dnadlinger

dtcallcock, 2020-10-28:
Unfortunately we don't have anyone here with the skills to seriously contribute to Pounder testing yet.

dnadlinger, 2020-10-28:
I didn't test it yet, as the near-term project for which I would have needed it (PLL for fibre noise cancellation) didn't materialise yet, and AFAIK also would have needed extra firmware work. @cjbe / @vmsch Are you planning on using Stabilizer/Pounder for any of the laser systems currently being materialised?

cjbe, 2020-10-28:
I am planning on using Pounder for both the PDH lock and phase noise cancellation for the new 729, but have not had bandwidth to test (nor a laser until Christmas).

vmsch, 2020-10-28:
We plan to switch to stabiliser at some point for B-field stabilisation, but not in the next few months.

jbqubit, 2020-12-05:
I've recently locked a noisy 435 nm ECDL to a 100 kHz cavity. Along the way we found there were fast frequency excursions that required loop bandwidth of about 10 MHz. The NIST SERVO latency was far too large. We finally ended up using MogLabs FSC.

Curious what the expected Pounder latency is. Has it been measured yet in the lab? Context is discussing with @gkasprow if Pounder will totally supersede NIST SERVO. Helps plan for which lasers Pounder will work with for cavity locks.

The NIST SERVO "is capable of feedback bandwidths up to roughly 1 MHz (limited by the 320 ns total latency)". Real-world latency may be greater if additional IIR filters are used. See Table 1. https://arxiv.org/abs/1508.06319

[Toptica FALC](https://www.toptica.com/products/laser-rack-systems/laser-locking-electronics/falc-110-mfalc-110-fast-pid/) is all-analog with 15 ns delay. [MogLabs Fast Servo Controller](https://www.moglabs.com/products/laser-electronics/fast-servo-controller) nist 40 ns.

dtcallcock, 2020-12-05:
Pounder is just a PDH lock signal generator.  I think you are really asking a question about the [Fast Servo](https://github.com/sinara-hw/Fast_Servo).  The nice thing about Pounder is that it will plug into the Fast Servo instead of requiring an extra box like  the NIST/Toptica/MogLabs parts you reference above.

Of course, the Pounder signal path adds some latency, especially from the low pass filter in the op-amp buffer.  I imagine it is comparable to anything else you might use though (once you've depopulated the LPF).

jbqubit, 2020-12-08:
Yes, I do mean Pounder + [Fast Servo](https://github.com/sinara-hw/Fast_Servo/wiki#overview). Looks like it's still early in Fast Servo testing & firmware development so it will be some time before its real-world latency can be measured, eh?

gkasprow, 2021-01-23:
We are currently porting NIST SERVO firmware to run on FastServo - we are changing the USB communication channel with ZynQ AXI. The rest of the gateware will be the same.

Closed 2023-09-21.

Thread 79 (2020-05-14):

IF amp oscillating

jordens, 2020-05-14:
@gkasprow you [mentioned](https://github.com/sinara-hw/Pounder/issues/19#issuecomment-569631706) the THS4631 is weird.
It oscillates when the IF gets to -0.4 V (at the output, G=3). A couple pF negative feedback fix it.

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

gkasprow, 2020-07-16:
The THS4631 input is weird. You cannot make classical integrator out of it for example due to strange non-lineairty.

gkasprow, 2021-01-23:
I added 4.7pF mounted by default

gkasprow, 2021-01-23:
There is new fast JFET opamp which behaaves as expected - it's OPA818

jordens, 2021-01-23:
THS4631DGN is still in the schematic v1.1rc1. don't you want to use the opa818?

gkasprow, 2021-01-23:
It has a completely incompatible footprint. I can add it as an assembly option and populate it by default.

jordens, 2021-01-24:
Maybe there are footprint compatible alternatives? The oscillation is really a functional problem. Or can we change the feedback to reliably prevent it?

gkasprow, 2021-01-24:
OPA657, AD8065

jordens, 2021-01-24:
AD8065 for lower power. I don't need offset stability or robustness against RF rectification. Can you add 100 or 1k series protection to ADC_[01]_P? The 50R termination would otherwise exceed abs max rating.

jordens, 2021-01-24:
Let's go for the AD8065.

gkasprow, 2021-02-03:
ok, done
added 50R resistors and replaced an opamp

Closed 2021-02-03.

Thread 80 (2020-05-15):

SMA for OUT1 not lined up to other SMAs

jordens, 2020-05-15:
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

needs to move out by about 0.5 to 1 mm

c.f. #75 PTH hole problem at the top SMA

gkasprow, 2021-01-23:
aligned them in the same way is in Urukul

Closed 2021-01-23.

Thread 81 (2020-06-11):

Missing level translation between STM32 and attenuators

dtcallcock, 2020-06-11:
See here: https://github.com/quartiq/stabilizer/issues/103

hartytp, 2020-06-12:
Isn't this the same as Urukul?

Interfacing between 5V and 3V3 logic directly isn't an issue so long as all logic thresholds are met and no absolute max rating is exceeded. @gkasprow or @jordens probably remember better than me, but IIRC this was all considered at design time; the logic levels are all fine and the 470Ohm resistors (in combination with the input clamping diodes) were chosen to be large enough to protect the CPLD/microprocessor inputs from the 5V outputs. So, this should all work fine without need for additional translators.

gkasprow, 2020-06-13:
Attenuators accept 3V3 logic, H state requires 3V or more. Exactly, 470R is used to avoid clamping

dnadlinger, 2020-06-13:
Can be closed, then?

jordens, 2020-06-15:
Are the logic levels fine? Certainly not on paper.
The attenuators want `V_ih = 3 V`, STM32H7 gives `V_oh = V_dd - 0.4 V = 2.9 V`. Same for the CPLD.

hartytp, 2020-06-15:
@jordens ok, thanks for elaborating. That does sound a bit marginal then.

gkasprow, 2020-06-16:
These Vdd-0.4 are usually specified under resistive load. We don't have such.

gkasprow, 2020-06-16:
We can add pullup to fix the potential issues

gkasprow, 2021-01-23:
added 10k pullups on MOSI and SCK

Closed 2021-01-23.

Thread 82 (2020-10-28):

wrong IC22 output voltage

gkasprow, 2020-10-28:
R136 should be 4k7

gkasprow, 2021-01-23:
Vfb is 0.7, not 0.8, fixed also annotation

Closed 2021-01-23.

Thread 83 (2020-11-03):

MFG issues

gkasprow, 2020-11-03:
R0402_47K_1%_0.0625W_100PPM has wrong PN field which indicated 51k resistor

Closed 2021-01-23.

Thread 84 (2020-12-09):

v1.1

jbqubit, 2020-12-09:
Talking to @dtcallcock about v1.1. @gkasprow discussed the following change.  https://github.com/sinara-hw/Pounder/issues/76#issuecomment-675129572

Are there are additional tests that need to be done on v1.0 before v1.1?

dtcallcock, 2020-12-09:
It would be good to measure the noise floor with output connected to input and phase adjusted to zero mixer output.   I'd do this both with an external instrument (via Stabilizer's analog in SMA) and via the Stabilizer's ADC.  I'm afraid I don't have boards or people to do this myself in the near term.

https://doi.org/10.1109/FCS.2011.5977868 gives an idea of how you might do this and where you'd expect to get to if the mixer was limiting.  The DDS is probably the limit here - see http://rubiola.org/pdf-slides/2012C-IFCS-DDS.pdf.  Hopefully the shared clock circuitry, power supplies, and thermal environment make some of the noise sources highlighted by Rubiola common-mode out, but AFAIK nobody in the literature has tested this.

jbqubit, 2020-12-09:
Who has copies of Pounder [v1.0](https://github.com/sinara-hw/Pounder/releases/tag/v1.0rc3)? I've checked with Technosystem and they have no v1.0 available.  Seems natural to apply round up testing and bug fixes for new round of v1.1 PCBs.

dtcallcock, 2020-12-11:
The phase detector sensitivity would be part of this measurement and should be documented (as a function of frequency).

This issue should probably be revisited at that point too: https://github.com/sinara-hw/Pounder/issues/28

gkasprow, 2021-01-22:
I discovered that have one copy of Pounder as well as Stabilizer. I also have  at home the VNA, SA and MW generator (square wave only) so can do some tests, but will need some help with software setup.

maciejprzybysz, 2023-10-23:
I closed this issue as it was about v1.1 and not updated over 2y.

In case this is still worth to do I made a separate issue for measurement task: https://github.com/sinara-hw/Pounder/issues/109

Closed 2023-09-21.

Thread 85 (2020-12-09):

measure noise floor

jbqubit, 2020-12-09:
cf https://github.com/sinara-hw/Pounder/issues/84#issuecomment-741345552

> It would be good to measure the noise floor with output connected to input and phase adjusted to zero mixer output.   I'd do this both with an external instrument (via Stabilizer's analog in SMA) and via the Stabilizer's ADC.  I'm afraid I don't have boards or people to do this myself in the near term.

> https://doi.org/10.1109/FCS.2011.5977868 gives an idea of how you might do this and where you'd expect to get to if the mixer was limiting.  The DDS is probably the limit here - see http://rubiola.org/pdf-slides/2012C-IFCS-DDS.pdf.  Hopefully the shared clock circuitry, power supplies, and thermal environment make some of the noise sources highlighted by Rubiola common-mode out, but AFAIK nobody in the literature has tested this.

kl2025, 2021-08-17:
Hello, as an intern in mlabs, I am following the above paper to do a quick test to measure the noise floor of the Pounder's mixer_ch_0 output, which is connected to the Stabilizer ADC_0.

My hardware test setup:
I am using Stabilizer v1.2 and Pounder v1.1. They are stacked together and Pounder OUT_0 is connected to IN_0 with a SMA cable. 50 ohm terminations are switched on for both stabilizer ADC channels.

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

My software test setup:
I am using Quartiq Stabilizer firmware and udp datastream to log the Stabilizer ADC data. So the Stabilizer ADC sampling rate is around 781.25 kHz or 1 data per 1.28 us.
Pounder OUT_0 is basically DDS_CH_0_OUT plus an attenuator. It is the RF source going to the mixer (through a SMA cable to Pounder IN_0) and it is set to output sine waves with frequency = 5 MHz, phase = around pi/2 (adjust until no dc in the mixer output) , amplitude = -16 dBm and output attenuation = 0 dB.
Pounder IN_0 has two signal paths: RF attenuator and internal LO source from DDS_CH1_OUT. RF attenuation is set at 10 dB so that the RF will become the suggested value of -26 dBm before the +31 dB amp. The LO is set to have frequency = 5 MHz, phase = 0, amplitude = -3 dBm to match the suggested value.

Both LO and RF signals meet at the mixer and the mixer IF output is logged from the Stabilizer ADC_0 data streaming.
Here are Stabilizer ADC_0 plot with ADC_0 gain set to 10 and its FFT spectrum using np.fft,rfft in python.

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

we guess the FFT peak at around 0.055 kHz is the 50 Hz mains hum.

I also connect stabilizer ADC_0 to a SIGLENT SDS2074X Plus oscilloscope with a SMA coaxial cable to look at the mixer output.
The signal looks like this :

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

A quick FFT of the signal in the oscilloscope is put here as a don't-be-serious reference. With limited oscilloscope bandwidth, I am not sure about the accuracy with this internal FFT function . So better check this again if someone has a proper spectrum analyzer.

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

It's my first time to do such noise measurement, feel free to let me know if there is anything I should improve, thank you.

gkasprow, 2022-07-29:
Measuring anything with scope requires caution. First, turn off the target's power supply but keep all the wires and loops the same. At least GND of the input power. MEasure with scope. Then turn on the power. MEasure again. You will often see very little difference due to the scope cable and ground loop pickup.

Thread 86 (2021-01-23):

v1.1 changelog

gkasprow, 2021-01-23:
- aligned SMA connectors #80
- added 22uF at the LDO outputs #77
- moved PCB edge #75
- fixed PN in 47k resistor #83
- R134, R166 changed to 0402 to lower the BOM count
- R136  -> 4k7 #82
- added 4.7pF to the THS4631D #79
- DDS_RESET connected to J10:11 (PG6) #76
 - SYNC_CLK connected to J10:18 (PA0) #76
 - removed SYNC_IN connection to CPU and R70 #76
 - THS4631 replaced by AD8065 #79
 -  ADT1-1WT replaced by  TC1-1T
 - added 50R resistors in series with CPU ADC inputs
 - making the RF amps DNP by default
-  swapped R15 with L85

jordens, 2021-01-23:
Great. Could you spin the RC production files so we can give it a quick check?

gkasprow, 2021-01-23:
[done](https://github.com/sinara-hw/Pounder/releases/tag/v1.1rc1)

jordens, 2021-01-24:
I had a look at the changes. Apart from the opamp change #79 I'm ok with v1.2 and would like to proceed with getting it manufactured. As a note I still think that:

* The baluns should all become TC1-1T (replace 7 ADT1-1WT)
* The use of pricey "special RF" capacitors for DC-blocks at 1-200 MHz is not supported by data, evidence, or experience with the other dozen designs that don't have and don't seem to require them. When I look at standard MLCC for DC-blocking in 1-200 MHz, they are all just fine.
* Putting RF output and RF input signal paths into the same RF shield box makes the purpose and benefit of the boxes unclear to me: is it for emission or immission or crosstalk?
* The RF output amplifiers can go away.

But since this is all still experimental, I'm not going to fight these.

jordens, 2021-02-03:
@gkasprow AFAICT there is only the opamp change (#79) pending for v1.2. Can we cut the release and send the production files?

gkasprow, 2021-02-03:
> The baluns should all become TC1-1T (replace 7 ADT1-1WT)

Just to simplify the BOM?

>    The use of pricey "special RF" capacitors for DC-blocks at 1-200 MHz is not supported by data, evidence, or experience with the other dozen designs that don't have and don't seem to require them. When I look at standard MLCC for DC-blocking in 1-200 MHz, they are all just fine.

I was curious about real benefits. We can always use Hi-Q caps instead.

>    Putting RF output and RF input signal paths into the same RF shield box makes the purpose and benefit of the boxes unclear to me: is it for emission or immission or crosstalk?

Only output path attenuator was placed under the shield, the PA sits on the other PCB side. If we discover crosstalk, I will place the attenuator on the bottom PCB side

>    The RF output amplifiers can go away.

Why?

jordens, 2021-02-03:
> Just to simplify the BOM?

BOM simplification, availability (the ADT1-1WT are quite a bit more exotic and hard to replace with anything footprint compatible, while the TC1-1T style is ubiquitous), and board space.

>  If we discover crosstalk

Right. We should measure crosstalk.

> The RF output amplifiers can go away.

They are typically not needed. Like for Urukul and Mirny, the usual amplifiers (e.g. Booster) would take 0 dBm (-5 dBm might be a little low however). And power usage: getting rid of them would reduce the power consumption by 0.7 W.

gkasprow, 2021-02-03:
The amplifier can be bypassed by the assembly option. I will make the bypass default configuration.

dtcallcock, 2021-02-03:
> They are typically not needed.

Actually I find the -5 to 10dBm range is often what you need to add few percent sidebands with a modulator device/laser input, and having to add an external amp to achieve these very modest signal levels would be annoying.  But as long as it's retained as an option then that's fine.

Noting on the schematic/wiki that an [ERA 50SM+](https://www.minicircuits.com/pdfs/ERA-50SM+.pdf) can be populated here instead would also be nice.  This extends the output to an even more useful +13dBm.  Sure it's another 280mW of power consumption but it's just a suggestion so nobody needs to compromise.

gkasprow, 2021-02-03:
[v1.1 release is ready](https://github.com/sinara-hw/Pounder/releases/tag/v1.1rc2)

gkasprow, 2021-02-03:
@kaolpr @akaminska

jordens, 2021-02-03:
Thanks!

dtcallcock, 2021-02-03:
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
Super minor, but can you make R34 the omitted component, not L15?  Any reasonable lab will have a kit with suitable resistors but the right inductor would probably have to be ordered.

gkasprow, 2021-02-03:
the inductor will make a stub

dtcallcock, 2021-02-03:
true dat

gkasprow, 2021-02-03:
One would have to order the amplifier anyway :)

dtcallcock, 2021-02-03:
Good point. Perhaps add the part number as a schematic annotation so one can order it without having to find an Altium licence though?

dnadlinger, 2021-02-04:
Shouldn't we be able to just flip them around? A 82 Ohm resistor should be low-enough Q at our frequencies? Just asking out of curiosity.

gkasprow, 2021-03-04:
yes, we can swap them. The resistor has smaller pads than the inductor so capacitance should be not an issue
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

Closed 2023-09-21.

Thread 88 (2021-01-24):

fix reference clock output label

jordens, 2021-01-24:
This is in fact a reference clock output. Let's label it "CLK OUT".
Also let's DNP it. The SMT MMCX are so easy to rip off and I'm not aware of a imminent and well-defined use case that would be able to use this clock.

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

gkasprow, 2021-01-25:
right!

gkasprow, 2021-01-25:
done

Closed 2021-01-25.

Thread 89 (2021-02-12):

trace impedance and separation

jordens, 2021-02-12:
The 50 Ohm signal traces seem to be really close to other traces, other pads, copper fill elements. Are the rules ok?

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

gkasprow, 2021-02-14:
it looks so.

jordens, 2021-02-14:
Yes. Coupling to the GND plane below may dominate making this OK.
Let's leave it open as one item for characterization: crosstalk. If that turns out to be problematic, we can look at swapping of the in/out DDS channels (much more separated routing without layer crossing jumpers) and separated shielding cans.

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

gkasprow, 2021-03-04:
I fixed the 3 first issues

gkasprow, 2022-07-29:
I improved trace routing - added GND copper shielding
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

jordens, 2022-07-29:
Nice. Thanks.

Closed 2022-07-29.

Thread 90 (2021-02-14):

Move DDS output termination resistors close to DDS, straighten bias

jordens, 2021-02-14:
The DAC outputs are high impedance and want their source termination close to them.
The eval board doesn't even use a defined diff pair impedance and instead just goes very close. According to ADI, improves SFDR.

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

gkasprow, 2021-03-04:
fixed
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

jordens, 2021-03-04:
Thanks!

Closed 2021-03-04.

Thread 91 (2021-03-03):

AD8065ARMZ (IC1) wrong P/N and footprint

mkiepiela, 2021-03-03:
The AMR suffix exists only for AD8066 (double opamp) where is a different pinout.
It has to be changed to AR (SOIC) or ART (SOT-23).
PCB needs to be modified.

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

gkasprow, 2021-03-03:
@mkiepiela was the PCB already produced? If so I can propose another amplifier. If not, I will change it to common SOIC.

mkiepiela, 2021-03-04:
@gkasprow No, it was not manufactured yet. Please change the footprint.

gkasprow, 2021-03-04:
ACK

gkasprow, 2021-03-04:
fixed

Closed 2021-03-04.

Thread 92 (2021-03-04):

J1, J10 wrong PNs in BOM

pkozakiewicz, 2021-03-04:
Correct PNs are given in LibRef column.

gkasprow, 2021-03-04:
right, it should be ESW-117-23-L-D

gkasprow, 2021-03-04:
and ESW-113-23-L-D

gkasprow, 2021-03-04:
It's clear now.
ESW-117-33-L-D-ND should be used with the original 3M connectors. They have 16.13 mm height; they need to be assembled in an elevated way
ESW-117-23-L-D should be used with IDC replacement connectors. They have a 13.59 mm height so will match the replacement connectors.

gkasprow, 2021-03-04:
@pkozakiewicz I drafted a [new release ](https://github.com/sinara-hw/Pounder/releases/tag/v1.1rc3)

pkozakiewicz, 2021-03-05:
@gkasprow Ok I'm launching the production now.

Closed 2021-03-04.

Thread 93 (2021-04-08):

Pounder may seat properly with pins incorrectly aligned

ryan-summers, 2021-04-08:
When mounting Pounder onto stabilizer, it's possible to inadvertently connect Pounder incorrectly onto the Stabilizer headers. Specifically, Pounder will properly seat 1 pin too high or low on the board.

When this occurs, it can be difficult to visibly see the alignment issue, but I have observed that my power supply begins to encounter over-current conditions on boot (presumably due to some short-circuit condition). We should likely select components such that incorrectly seating the device is not possible.

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

jordens, 2021-04-08:
Don't the connectors interfere? After all those are tub-style and I don't see how they could mate with an offset.

ryan-summers, 2021-04-08:
There's enough clearance such that it still fits. I don't notice much difference in the force required either.

jordens, 2021-04-08:
Ok. Then let's look for keyed female connectors.

gkasprow, 2021-04-08:
Are you able to mount spacers? I don't think so. They are included in the BOM, so should be mounted.

gkasprow, 2021-04-08:
I tried to find suitable connectors with the right height and it was tough. Maybe would be good to glue in 2mm pieces of some plastics into the Stabilizer connector edges.

jordens, 2021-04-10:
The spacers were not supplied.

jordens, 2021-05-31:
Maybe we could just use an oversized Samtec ESW-1xx-23-L-D to resolve this. Since the current size fits fine at +-1 row offset, we should just use that part with two more (unused) rows so it can't be inserted at an offset.

gkasprow, 2022-07-31:
I added holes that enable assembly of oversized connections

Thread 94 (2021-05-31):

Temperature measurement with power detector

jordens, 2021-05-31:
The power detectors are reasonably close to the RF sections. I'd like to use them for temperature monitoring in a precision measurement. Let's connect their temperature PTAT output to the unused CPU ADC inputs.

* Appropriate voltage divider 5V to 3V.
* We can use IN2_N in single ended mode.
* IC10A TEMP to JADC1_IN2_N
* IC10B TEMP to JADC2_IN2_N

jordens, 2022-07-28:
You are right. Divide to 2.048 V

gkasprow, 2022-07-28:
2k and 3k are a bit low, but we already have them in BOM
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

jordens, 2022-07-28:
@gkasprow I had another look.
For 125 C it would be 1.9 V max. And we have protection diodes there. Just go with 10k series. No divider needed.

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

gkasprow, 2022-07-28:
OK

Closed 2022-07-28.

Thread 95 (2021-05-31):

Power measurement redesign

jordens, 2021-05-31:
The power measurement circuit doesn't seem to work well. I'm mostly measurring ~1V output on the detector almost independent of how much power is at the input.

* The impedance isn't matched. The tap has 525 R output impedance towards the detecor, the detector has a 50 R input. One would think that's fine given the short (~20 mm) trace but it looks weird. Let's make it a proper discrete 1:10 (20 dB) splitter or use a integrated tap.
* Let's place the detector tap (R12, R17) after the preamps (IC2). No need to loose more precious power at the input. The working power range is also badly matched to what's typically available before the amplifier including the tap loss. With the tap after the amplifier we can do AGC and gain 32 dB of dynamic range on the detector for signal searching.
* The detectors (IC10) are pretty hungry (350 mW each). Can we use their power down interface with GPA7 and GPA6 of the gpio extender IC19?

jordens, 2021-06-04:
* VTGT: Due to the input bias current and input impedance the voltage is 1.35 V (instead of 1.4 V), close to the minimum of 1.3 V. The eval board has a lower impedance divider (1k4 || 845R) than ours (5k6 || 3k6). Let's take the voltage divider from the eval board.

jordens, 2021-06-04:
* The VOUT is 0-5 V (maybe 0-3 in practice) output. The JADC[12]_IN2_P are 0-2 V. Add a 2/5 voltage divider.

gkasprow, 2022-07-28:
the TCM2 pin requires nearly 5V to disable the chip.
I used more common resistors to get 1.4V from 2.3V

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

gkasprow, 2022-07-28:
@jordens I assume you are talking about such splitter
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

gkasprow, 2022-07-28:
it has 20dB tap and 1.7dB insertion loss

jordens, 2022-07-28:
Exactly. All R close together.

MatBier, 2023-01-04:
@jordens @gkasprow
I encountered a problem with power measurement when testing Pounder 1v2.
I've tested 3 boards and on all of them output voltage from power detector is stuck on max voltage (around 4.3V - 4.8V depending on the board). Output is not affected by variable input power and attenuation level. Problem seems to look like one from May 31, 2021 comment, but I also checked power measurements on one Pounder 1v0 board and I was able to detect it normally.

I changed resistor values in power splitter on one of 1v2 PCBs but it doesn't seem to help.

jordens, 2023-01-04:
I haven't tested the new power detector design.

jordens, 2023-01-04:
Maybe it's in power down mode?

MatBier, 2023-01-05:
It is most definitely in operational mode, when in power down output is 0V.

gkasprow, 2023-01-05:
The difference between these two designs is the way how RF signal is sourced.
New revision gets the signal after IC2 amplifier so it means it is nearly 30dB stronger. Instead of -26dBm -  20dB = 46dBm now we get 5dBm-20dB = -15dBm. That should be still within the range of the detector

gkasprow, 2023-01-05:
we also changed the VTGT value from 1.35V to 1.4V. Please check if pin 12 is 1.4V

gkasprow, 2023-01-05:
Please also check voltage on pins 1 and 16

MatBier, 2023-01-10:
Turns out voltage on pin 12 is 0.88V. There is a mistake on the schematic - R16 and R63 values should be switched. With proper resistors power meter works properly.

Closed 2022-07-29.

Thread 97 (2021-05-31):

Attenuator MISO level resistance.

jordens, 2021-05-31:
The attenuator is driving 5V into 1k5 + 50R and then MISO of the 3.3V CPU.

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

1mA injected into the power rails still seems significant.
Can we increase that R41 resistance a bit to 10k? No need for speed. It's a slow bus.

c.f. #81

gkasprow, 2022-07-28:
done

gkasprow, 2022-07-28:
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

Closed 2022-07-28.

Thread 98 (2021-05-31):

Place output amplifiers

jordens, 2021-05-31:
My line of thought asking for the default no placement of the output amplifiers wasn't really smart.
Compared to other elements (e.g. the detectors) they consume a manageable amount of power. Let's mount them.

* Place IC11A IC11B R85A L15B
* DNP R86A R86B

gkasprow, 2022-07-28:
done
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

Closed 2022-07-28.

Thread 99 (2021-05-31):

IF amp filter and gain

jordens, 2021-05-31:
* This should read "0 dBm ..."
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

* At the sum mixer product (of >20 MHz) it's OK and beneficial to use very low impedance. That makes the mixer happy and also helps with suppressing recification in the opamp. Let's make a 10 MHz Chebyshev pi-filter:
  * DNP R22A,B
  * R62A,B = 49R4
  * R63A,B = 0R
  * C27A,B, C28A,B around 560 pF
  * L8A,B around 1 µH

* IMO the IF amp gain should be increased from 3 to 10 for all use cases:
  * Only the double-saturated use case of the mixer will get anywhere near 0 dBm output. All other use cases will need to stay significantly below (like -6 dBm).
  * We have the in-amp on Stabilizer that can cope fine with +-3V. Using low gain there also makes it faster and less noisy overall.

jordens, 2021-06-01:
We could also consider a proper anti-aliasing lowpass here.

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

jordens, 2021-06-05:
And I would like to consider a better noise match to the 50R mixer IF impedance. The FET opas are cool for high impedance sources but that's not what we have here. DC offset isn't a big problem since it's typically dwarfed by the mixer DC offset (~0.5 mV). Rectification to me seems to be the same effect as what the mixer itself would be limited by.

gkasprow, 2022-07-28:
@jordens where would you put such LC anti-alias filter? Shall I add more LC sections before the opamp? I can add another placeholder for LC section.

gkasprow, 2022-07-28:
In terms of an opamp, what about [ADA4896/7  ](https://www.analog.com/media/en/technical-documentation/data-sheets/ADA4896-2_4897-1_4897-2.PDF)

jordens, 2022-07-28:
Let's go for this filter:

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

* Plase that filter between mixer IF and opamp. The only resistor should be a RL = 50 R termination but after the filter. Keep C60 at the opamp input. R21=0R. Remove R9 traces (potential for annoying positive feedback). Make the opamp with gain=20 (to also lift it over the INA noise which is best case 18 nV/rtHz), cap its gain to 1 MHz.

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

* Make sure the mixer sum products (5-500 MHz) see low impedance (< 50R, can be capacitive). Shunt-first Chebychev helps here, but let's put a 33 pF in parallel to that first big shunt C.
* [ADA4896/7](https://www.analog.com/media/en/technical-documentation/data-sheets/ADA4896-2_4897-1_4897-2.PDF) looks good to me in gain=20

gkasprow, 2022-07-29:
I got rid of the notch filter and other options to make space
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

jordens, 2022-07-29:
Perfect

Closed 2022-07-29.

Thread 100 (2021-06-10):

Square up LO

jordens, 2021-06-10:
To reduce the mixer temperature coefficients, LO AM-PM sensitivity, and distortion, it would be very useful to increase the slew rate and square it up.

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

This could be done in differential signalling. In that case we would want a differential AA filter or two matched filters and a high gain, low jitter, limiting clock buffer. If possible, that clock buffer would replace the amplifier IC13A/B.
Maybe we can even go differentially (differential clock buffer) into the mixer LO at significant benefit (LO isolation). We should just double-check that the GND pin opposing LO is actually the other end of the LO balun winding).
A frequency-scaled version of the [AD9912-EVAL FDBK-IN reconstruction filter](https://www.analog.com/media/en/technical-documentation/user-guides/EVAL-AD9912A_PCBZ_UG-475.pdf) would be a good start. Also [AN-837](https://www.analog.com/media/en/technical-documentation/application-notes/351016224AN_837.pdf) has some good advice.

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

gkasprow, 2022-07-28:
MAybe use sth like [LTC6957](https://www.analog.com/media/en/technical-documentation/data-sheets/6957fb.pdf)?
LTC6957-4 has CMOS Logic, Complementary Outputs

gkasprow, 2022-07-28:
@jordens, what cut-off frequency would you like to have?

gkasprow, 2022-07-28:
what's wrong with the LTCC filters we use right now? We can use more of them to get rid of aliasing.

jordens, 2022-07-28:
The LTCC filters are fine but single ended. With a balanced filter, differential (in and out) clock buffer we'd be all differential and save the balun as well.
But honestly idea is a bit more experimental and risky than I'd dare put into the next iteration without prototyping it first. Let's leave it out and open for now. Maybe somebody wants to pursue this as an experiment. I'd certainly be interested in seeing the result.

gkasprow, 2022-07-29:
I thought you want to put the filter before the buffer to make perfect sine and then convert it to perfect square wave.

jordens, 2022-07-29:
Yes. Filter before buffer.
My goal with the balanced filters would have been to have then entire chain (DDS, filter, buffer, Mixer LO) balanced and never convert to/from unbalanced. That's what they do

gkasprow, 2022-07-29:
OK. it's better to design a simple PCB with components and connect only IN, OUT and supply
I't put there entire chain; filter, clock buffer, mixer, and output filter. I can also shape it in such way that you can solder it on top of Phaser board without using long wires. - just remove old components from PCB and fit everything under the shield.
the only signal that would need to be delivered is twisted pair from DDS

jordens, 2022-07-29:
If you can find the space on the board (for a balanced filter + buffer as a bypass to the chain of dds output balun + LTCC filter + pad + RF amplifier) then add them. Otherwise I'd say leave it as is.

[LMK1D2102RGTR](https://www.ti.com/lit/ds/symlink/lmk1d2102.pdf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) is also an as buffer.

gkasprow, 2022-07-29:
I have some place on the bottom so can try to install it there.

gkasprow, 2022-07-29:
I'm not sure if LVDS can drive 10dBm (1.2V peak) into a 100Ohm load.
It usually has only 4mA of current.
LVPECL is a better option and would give much better rise time than CMOS.
CMOS output is too strong and we would have to attenuate it.

jordens, 2022-07-29:
The mixer LO is 50 Ohm, also if we use it differential.

gkasprow, 2022-07-29:
right, that's even worse in case of LVDS

gkasprow, 2022-07-29:
What cutoff frequency do you want for the differential path? 160MHz?

gkasprow, 2022-07-29:
@jordens and what order of the filter do you need?

gkasprow, 2022-07-29:
@jordens what about such circuit?
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

gkasprow, 2022-07-29:
and filter characteristics
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

gkasprow, 2022-07-29:
the driver resistance is very low (open emitter). Maybe we should add two 24Ohm resistors to make it a 50Ohm differential...
The driver provides 1.6Vpp, but with matching that would be halved.

jordens, 2022-08-01:
The LO port is a very non-linear one anyway (it's two series pairs of diodes): VSWR against 50 Ohm 7 dBm is 2.5, and 50 Ohm 10 dBm is 3.5. As long as you saturate them well and the buffer chip is happy with the load, and there is no long lines between buffer and mixer, we should be fine without any termination (R100, 101, 102). Maybe series resistors to limit the current would be better.

As filter, with 250 MHz Nyquist, I'd go for something like this (balanced, i.e. doubled up; but component values don't matter now since it's a variant anyway).
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

gkasprow, 2022-08-01:
We need R100, 101, and 102 because they act as pulldown. And these pulldown resistors limit the current. The LVPECL is an open emitter output stage.
I marked these filter components as DNP and placed the values you suggested.

jordens, 2022-08-01:
Ack. I got it now.
Looking at the VSWR the LO port of the mixer is more like an "average" 15 - 20 Ohm impedance for a sine wave at 10-7 dBm. As would be expected from 2 diodes. With that in mind R100/R102 could actually be large (e.g. 100 Ohm) to maximize power into LO and R101 to something lower like 0R to adjust the working point.
All up for tuning.

gkasprow, 2022-08-01:
When you look at the datasheet, the output voltage amplitude does not depend much on the load resistor. You only change the offset. But yes, a higher value will dissipate less power.

gkasprow, 2022-08-01:
I mean this plot
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

jordens, 2022-08-01:
Yep.

Closed 2022-08-01.

Thread 101 (2022-05-19):

parts availability

gkasprow, 2022-05-19:
https://github.com/sinara-hw/Kasli/issues/97

gkasprow, 2022-06-06:
@jordens it's impossible to source MCP23017 in any package.
What about adding footprint for [PCF8575](https://www.ti.com/lit/ds/symlink/pcf8575.pdf?ts=1654434860246&ref_url=https%253A%252F%252Fwww.google.com%252F) or [PCA9539](https://www.ti.com/lit/ds/symlink/pca9539.pdf?ts=1654510586170&ref_url=https%253A%252F%252Fwww.google.com%252F) ?

jordens, 2022-06-06:
Please do use an available one!
Either is fine from the software perspective.

gkasprow, 2022-07-28:
sure

Closed 2022-07-28.

Thread 102 (2022-06-21):

screws

gkasprow, 2022-06-21:
the screw heads on the mirny underside are thicker than allowed and interfere with the adjacent panel's gasket.

gkasprow, 2022-07-28:
replaced with BOSSARD_BN5687-3061605_v

Closed 2022-07-28.

Thread 103 (2022-07-13):

DDS baluns/termination are wrong

jordens, 2022-07-13:
The source output impedance after the baluns (TR9 etc) is 100 Ohm currently. The filters want 50 Ohm. (The eval board also has a 100 Ohm single ended output impedance from DAC1_OUT into 50 Ohm filters/SMA output which doesn't sound optimal).
We can either make the source termination R24...R35 25R or use TC2-1TX+ as baluns. The latter gives more power and is still within DAC compliance.

gkasprow, 2022-07-28:
fixed
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

jordens, 2022-08-01:
Just to remind myself of the context:

Datasheet says:

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

While the text is consistent, the figure is wrong.
Note the missing resistors at the source side of the balun. The Source would be ~100 k impedance.

Eval board has:

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

This is also wrong.
The 50 R are populated. Hence the source impedance is 100 R. The balun is 1:1. DAC_OUT is 50 R (filter and SMA)

Various ANs from ADI with different information:

https://www.analog.com/media/en/technical-documentation/application-notes/an_912.pdf looks trustworthy and is consistent.

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

https://www.analog.com/media/en/training-seminars/tutorials/MT-019.pdf similarly consistent.

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

https://www.analog.com/media/en/training-seminars/design-handbooks/Technical-Tutorial-DDS/Section6.pdf is wrong.

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

The AD9850 is also an unterminated current source with 100 k impedance.

Some Analog forum posts indicating the obvious, that this is indeed a current source and the source termination should match the load impedance:

https://ez.analog.com/dds/f/q-a/536170/ad9959-output-impedance
https://ez.analog.com/dds/f/q-a/28841/ad9959---no-ac-output-improper-termination

Closed 2022-07-28.

Thread 104 (2022-07-25):

better panel ADC labels

jordens, 2022-07-25:
The two MCX ADC inputs currently labeled ADC0 and ADC1. This is confusing as it collides with the labels of the Stabilizer SMA ADC inputs. Better labels would be "AUX ADC0" and "AUX ADC1", assuming that fits.

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

gkasprow, 2022-07-28:
fixed
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

Closed 2022-07-28.

Thread 106 (2022-08-01):

Add i2c eeprom

jordens, 2022-08-01:
To identify Pounder and distinguish it from other mezzanines, we should add an eeprom (Driver already has it) on the I2C bus.
Nominated for v1.2 if it's not too late.

jordens, 2022-08-01:
We could use the different i2c switch as an indicator. But that's obviously a shortsighted idea as nothing prevents other mezzanines from using those as well.

gkasprow, 2022-08-01:
we can use another switch as a revision indicator (4 bits) and board type indicator (another 4 bits)

gkasprow, 2022-08-01:
On the other side, it would be good to do it as on the Driver mezzanine

gkasprow, 2022-08-01:
I added an EEPROM

Closed 2022-08-01.

Thread 107 (2022-10-07):

review v1.2

filipswit, 2022-10-07:
- [x] Polygons aren't poured in proper order, so 3 of them them aren't poured at all or are improperly poured.
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

- [x] Additionally I'd add decap for IC16

gkasprow, 2022-10-10:
fixed

Closed 2022-10-10.

Thread 108 (2023-01-10):

wrong power detector VTGT

jordens, 2023-01-10:
Turns out voltage on pin 12 is 0.88V. There is a mistake on the schematic - R16 and R63 values should be switched. With proper resistors power meter works properly.

_Originally posted by @MatBier in https://github.com/sinara-hw/Pounder/issues/95#issuecomment-1377518420_

Both channels.

jordens, 2023-06-26:
R63A/B: 750R
R14A/B: 1k2

gkasprow, 2023-07-21:
added fixed PnP and BOM files to existing release

Closed 2023-09-21.

Thread 109 (2023-10-23):

Pounder noise floor measurement

maciejprzybysz, 2023-10-23:
It would be good to measure the noise floor with output connected to input and phase adjusted to zero mixer output.   I'd do this both with an external instrument (via Stabilizer's analog in SMA) and via the Stabilizer's ADC.  I'm afraid I don't have boards or people to do this myself in the near term.

https://doi.org/10.1109/FCS.2011.5977868 gives an idea of how you might do this and where you'd expect to get to if the mixer was limiting.  The DDS is probably the limit here - see http://rubiola.org/pdf-slides/2012C-IFCS-DDS.pdf.  Hopefully the shared clock circuitry, power supplies, and thermal environment make some of the noise sources highlighted by Rubiola common-mode out, but AFAIK nobody in the literature has tested this.

_Originally posted by @dtcallcock in https://github.com/sinara-hw/Pounder/issues/84#issuecomment-741345552_

dnadlinger, 2023-11-03:
Related: https://github.com/sinara-hw/Pounder/issues/110 (though this is apparently using downconversion to ~250 kHz IF, not DC, so the close-in properties will presumably be different).

Here is a screen capture for posterity (according to Robert, the axis scaling is off by a factor ~2000×):
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

Thread 110 (2023-10-30):

superhet noise floor

jordens, 2023-10-30:
Just for reference as this was requested a couple times:
Here's the loopback phase noise floor in a super-heterodyne configuration (Pounder v1.2, ~160 MHz carrier, ~250 kHz IF). Scale the plot from 200 MS/s (in the video) to ~100 kS/s to get the right axes. Integrated jitter from 0.1 Hz to 50 kHz is then 2.2e-4 rad. Tempco is around 1.3e-3 rad/K ~ 1.2 ps/K here.
https://github.com/quartiq/stabilizer-stream

jordens, 2023-11-01:
closing as non-actionable

Closed 2023-11-01.
