sinara-hw/Pounder/(list of files, drawings)

Other design files:
panel/Panel_Pounder.PcbDoc
pcb/Digital_Attenuator.SchDoc
pcb/Digital_Attenuator_Amp.SchDoc
pcb/mechanics.SchDoc
pcb/Mixer_coupler.SchDoc
pcb/power_supplies.SchDoc
pcb/PWR_Det.SchDoc
pcb/Quad_DDS.SchDoc
pcb/Stabilizer_Pounder.PrjPCB
pcb/Stabilizer_Pounder.SchDoc
