sinara-hw/Pounder/(commit log)

2019-09-29 fixed #12
    [COM_DIO_MCX.PCBDOC, COM_DIO_MCX.PrjPCB, COM_DIO_MCX.schdoc, DIO_MCX.PrjPCB, DIO_MCX.schdoc, DIO_MCX_Supply.SchDoc, DIO_MCX_mezzanine.PrjPCB, Digital_Attenuator_Amp.SchDoc]
2019-12-30 initial PCB done
    [Digital_Attenuator_Amp.SchDoc, Mixer_coupler.SchDoc, PWR_Det.SchDoc, Quad_DDS.SchDoc, Stabilizer_Pounder.PrjPCB, Stabilizer_Pounder.SchDoc, mechanics.SchDoc, power_supplies.SchDoc]
2020-01-21 fixed #74 #73
    [Digital_Attenuator.SchDoc, Stabilizer_Pounder.SchDoc]
2022-07-31 v1.2 cosmetics & added variants
    [Mixer_coupler.SchDoc, Quad_DDS.SchDoc, Stabilizer_Pounder.PrjPCB, Stabilizer_Pounder.SchDoc, power_supplies.SchDoc]
2022-08-01 added EEPROM, changed LC filter values
    [Mixer_coupler.SchDoc, Quad_DDS.SchDoc, Stabilizer_Pounder.PrjPCB, Stabilizer_Pounder.SchDoc]
2022-08-17 replaced component libraries
    [Mixer_coupler.SchDoc, Stabilizer_Pounder.PrjPCB]
2022-09-09 SMA connectors replaced by Delock ones
    [Stabilizer_Pounder.PrjPCB, Stabilizer_Pounder.SchDoc]
2022-10-10 fixed #107
    [Stabilizer_Pounder.PrjPCB, Stabilizer_Pounder.SchDoc]
2023-07-21 fixed issue 108, R63A/B: 750R R14A/B: 1k2
    [PWR_Det.SchDoc, Stabilizer_Pounder.PrjPCB]
2023-09-21 v1.2.1rc1 - Impedance profile added - P_version project parameter added - Version on schematic docs, PCB, panel updated - Validation errors, component links updated - Bottom overlay text out of board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
    [Digital_Attenuator.SchDoc, Mixer_coupler.SchDoc, PWR_Det.SchDoc, Panel_Pounder.PcbDoc, Quad_DDS.SchDoc, Stabilizer_Pounder.PrjPCB, Stabilizer_Pounder.SchDoc, mechanics.SchDoc]
